molejar/easyboard/README.md

# Rapid Development Platform

EasyBoard Nano (EBN) represent the hardware modular concept for rapid development and prototyping.
Thanks to high scalability it's covering a wide area of applications and technologies.

## EBN HW

## EBN SW
