molejar/easyboard/hw/README.md

# EasyBoard Nano HW

* [EBN_KL27Z4](EBN_KL27Z4) - KL27Z4 Core Shield
* [EBN_FMPA](EBN_FMPA) - FM Radio + 2x5W PA Shield
* [EBN_OLED](EBN_OLED) - I2C and SPI OLED Shield
* [EBN_S12D](EBN_S12D) - 12 Dimension Sensor Shield
* [EBN_WPWR](EBN_WPWR) - Wireless Power Shield
* [EBN_SBAT](EBN_SBAT) - Smart Battery Shield
* [EBN_STOR](EBN_STOR) - Storage Shield
* [EBN_GPS](EBN_GPS) - GPS + SD Card Shield
* [EBN_DUAL](EBN_DUAL) - Extendable Shield
* [EBN_PROTO](EBN_PROTO) - Prototype Shield
