molejar/easyboard/hw/EBN_FMPA/README.md

# EBN: FM Radio Shield

#### General Info

* **Base On:** RDA5807M (Single-Chip Broadcast FM Radio Tuner with RDS)
* **Output PA:** PAM8403/PAM8406 (FilterLess 3W/5W Class-D Stereo Audio Amplifier)
* **Control Pins:** Two GPIOs for Enable/Disable MUTE and SHUTDOWN
* **Main Interface:** I2C for tuning and controlling RDA5807M

### Blocking Diagram

<p align="center">
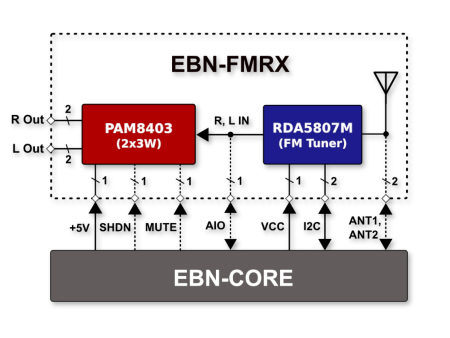
[picture p1: hw/EBN_FMPA/images/EBN_FMRX_V01_BD.png]
EBN-FMPA Block Diagram
  
</p>

### PinOut

<p align="center">
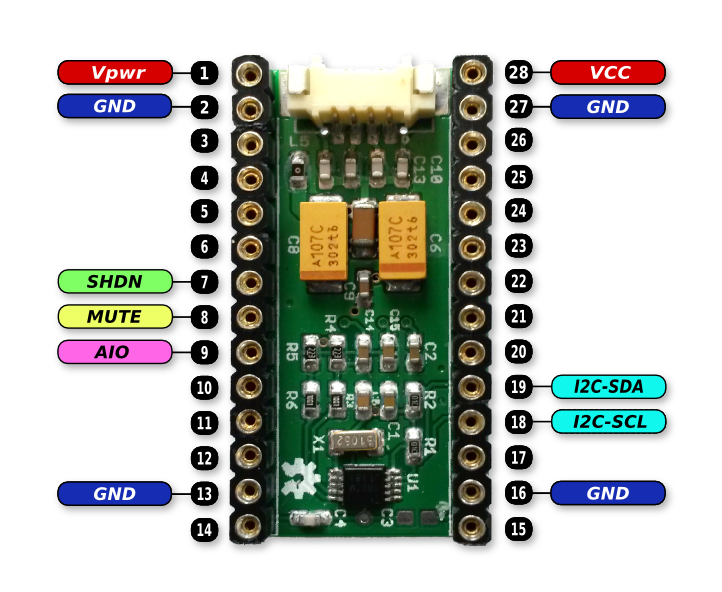
[picture p2: hw/EBN_FMPA/images/EBN_FMRX_V01_PinOut.png]
EBN-FMPA PinOut
  
</p>

#### Connection with Core Shield

| EBN-FMPA | EBN-KL27Z4  |
| --- | --- |
| I2C-SDA | PTB1 |
| I2C-SCL | PTB0 |
| SHDN | PTA1 |
| MUTE | PTA2 |
| AIO | PTE30 |

### Design files

 * [Schematic & PCB (Eagle 7.x)](eagle)
