molejar/easyboard/hw/EBN_KL27Z4/README.md

# EBN: KL27Z4 Core Shield

#### General Info

* **MCU:** Freescale MKL27Z256VFM4 in QFN32 package
* **ARM Core:** Cortex-M0+, 50MHz (max)
* **Memory's:** 256kB Flash and 32kB RAM
* **Serial Interfaces:** 1xUSB-Device, 3xUART, 2xSPI, 2xI2C, 1xI2S, ...
* **Other:** 16-bit ADC, 12-bit DAC, RTC, FlexIO (4xIO-Pins)

### Blocking Diagram

<p align="center">
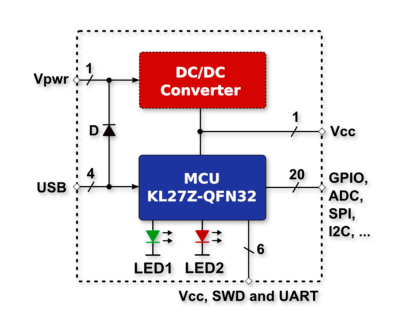
[picture p5: hw/EBN_KL27Z4/images/EBN_CORE_KL27Z4_V04_BD.png]
EBN-KL27Z Block Diagram
  
</p>

### PinOut

<p align="center">
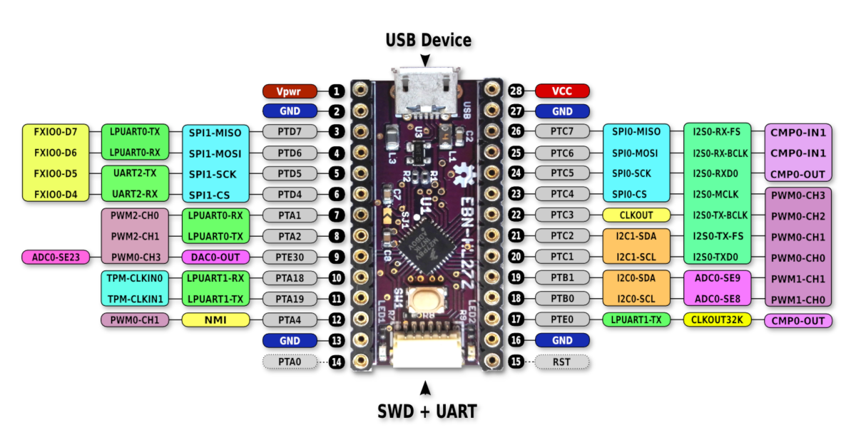
[picture p6: hw/EBN_KL27Z4/images/EBN_CORE_KL27Z4_V05_PinOut.png]
EBN-KL27Z PinOut
  
</p>

#### Internal Connections

| Name | Pin | Description |
| --- | --- | --- |
| LED1 (Green) | VCC | Power Status LED |
| LED2 (Red) | PTA3 | User or Error Status LED |
| SW1 (Button) | PTA4 | Enter into Bootloader |

### Design files

 * [Schematic & PCB (Eagle 7.x)](eagle)

### OSH Park
