molejar/easyboard/hw/EBN_PROTO/README.md

# EBN: Prototype Shield

#### General Info

### Design files

 * [Schematic & PCB (Eagle 7.x)](eagle)
