molejar/easyboard/hw/EBN_S12D/README.md

# EBN: Sensor Shield

#### General Info

* **Accelerometer:** FXOS8700
* **Magnetometer:** FXOS8700
* **Barometer:** MPL3115
* **Gyroscope:** FXAS21002
* **Humidity:** SHT2X

### Block Diagram

<p align="center">
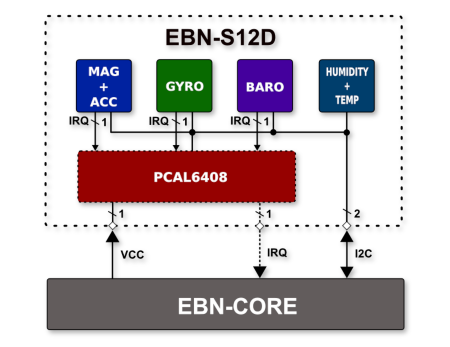
[picture p10: hw/EBN_S12D/images/EBN_S12D_V02_BD.png]
EBN-S12D Block Diagram
  
</p>

### PinOut

<p align="center">
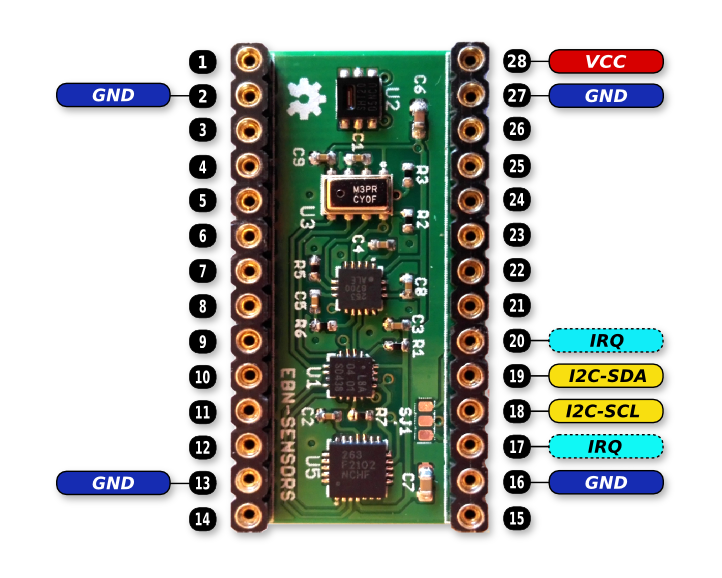
[picture p11: hw/EBN_S12D/images/EBN_S12D_V02_PinOut.png]
EBN-S12D PinOut
  
</p>

#### Connection with Core Shield

| EBN-S12D | EBN-KL27Z4  |
| --- | --- |
| I2C-SDA | PTB1 |
| I2C-SCL | PTB0 |
| IRQ (20 / 17) | PTC1 / PTE0 |

### Design files

 * [Schematic & PCB (Eagle 7.x)](eagle)
