molejar/easyboard/hw/EBN_SBAT/README.md

# EBN: Smart Battery Shield

#### General Info

* **Charger:** TI bq24075 (1A Li-Ion linear charger with power path)
* **BMS:** TI bq27421-G1 (System-Side Impedance Track Fuel Gauge With Integrated Sense Resistor)
* **DC/DC:** TI TPS6300x (High Efficient Single Inductor Buck-Boost Converter 3.3V/1A)

### Blocking Diagram

<p align="center">
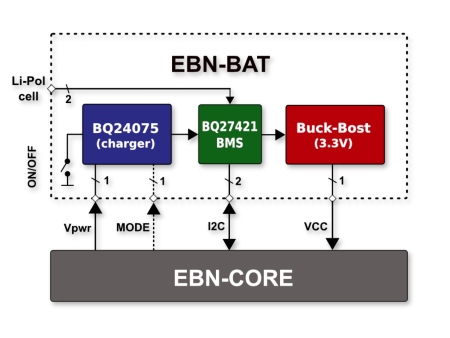
[picture p12: hw/EBN_SBAT/images/EBN_SBAT_V01_BD.png]
EBN-SBAT Block Diagram
  
</p>

### PinOut

<p align="center">
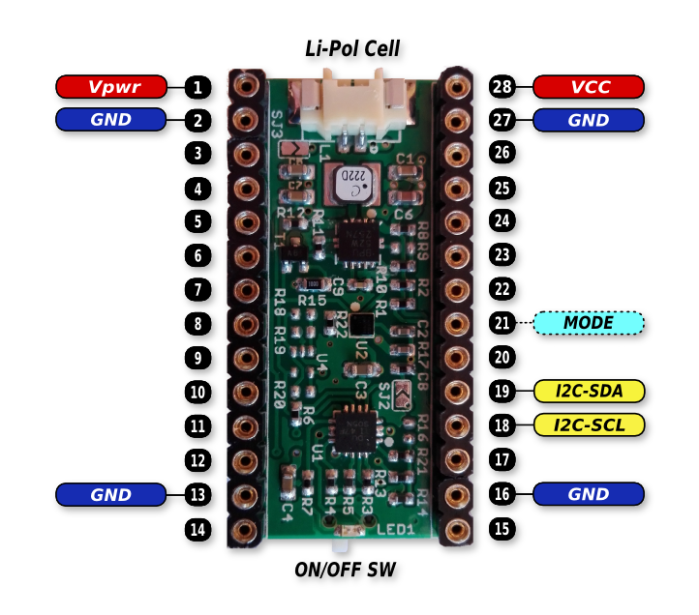
[picture p13: hw/EBN_SBAT/images/EBN_SBAT_V01_PinOut.png]
EBN-SBAT PinOut
  
</p>

#### Connection with Core Shield

| EBN-SBAT | EBN-KL27Z4  |
| --- | --- |
| I2C-SDA | PTB1 |
| I2C-SCL | PTB0 |
| MODE | PTC2 |

### Design files

 * [Schematic & PCB (Eagle 7.x)](eagle)

### OSH Park
