molejar/easyboard/hw/EBN_STOR/README.md

# EBN: Storage Shield

#### General Info

* **Base On:** Three different kinds of memories (SD Card, NAND Flash and EEPROM)
* **Micro SD Card:** Any type compatible with 3.3V power and SPI I/O interface
* **SPI Flash:**  ...
* **I2C EEPROM:**  ...

### Block Diagram of Storage Shield

<p align="center">
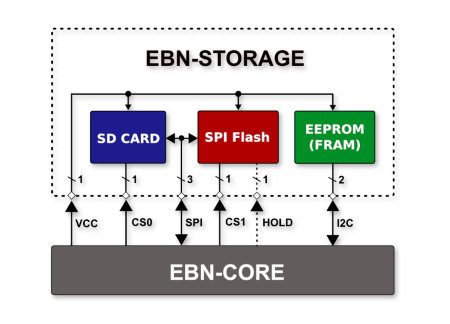
[picture p14: hw/EBN_STOR/images/EBN_STORAGE_V01_BD.png]
EBN-STORAGE Block Diagram
  
</p>

### PinOut

<p align="center">
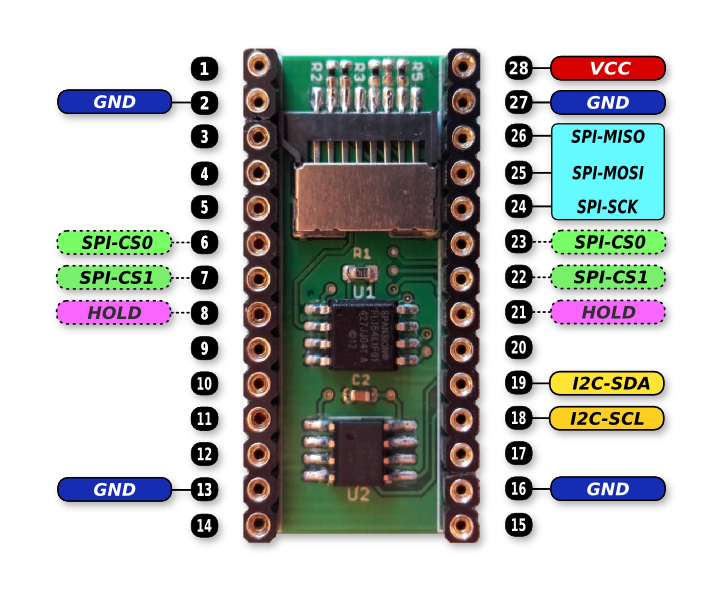
[picture p15: hw/EBN_STOR/images/EBN_STORAGE_V01_PinOut.png]
EBN-STORAGE PinOut
  
</p>

#### Connection with Core Shield

| EBN-STORAGE | EBN-KL27Z4  |
| --- | --- |
| SPI-MISO | PTC7 |
| SPI-MOSI | PTC6 |
| SPI-SCKL | PTC5 |
| SPI-CS0 (06 / 23) | PTD4 / PTC4 |
| SPI-CS1 (07 / 22) | PTA1 / PTC3 |
| HOLD (08 / 21) | PTA2 / PTC2 |
| I2C-SDA | PTB1 |
| I2C-SCL | PTB0 |

### Design files

 * [Schematic & PCB (Eagle 7.x)](eagle)
