molejar/easyboard/hw/EBN_WPWR/README.md

# EBN: Wireless Power Shield

#### General Info

* **Base On:** TI bq51013B (Highly Integrated Wireless Receiver Qi with 5V/1A Output)
* **DC/DC:** Optional DC/DC Buck Converter with 3.3V/1A Output

### Block Diagram

<p align="center">
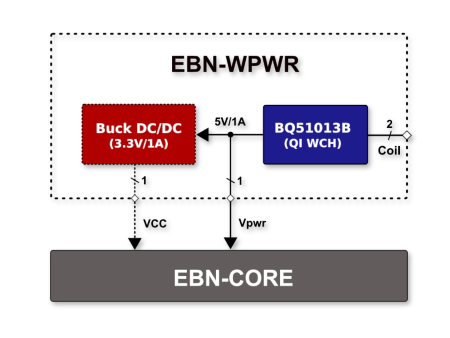
[picture p16: hw/EBN_WPWR/images/EBN_WPWR_V01_BD.png]
EBN-WPWR Block Diagram
  
</p>

### PinOut

<p align="center">
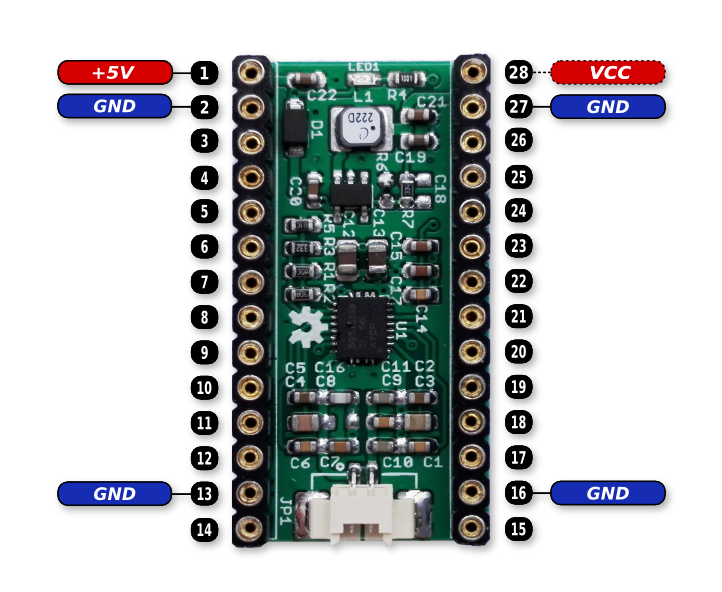
[picture p17: hw/EBN_WPWR/images/EBN_WPWR_V01_PinOut.png]
EBN-STORAGE PinOut
  
</p>

### Design files

 * [Schematic & PCB (Eagle 7.x)](eagle)
