molejar/easyboard/hw/EBN_FMPA/images/EBN_FMRX_V01_Bottom.png

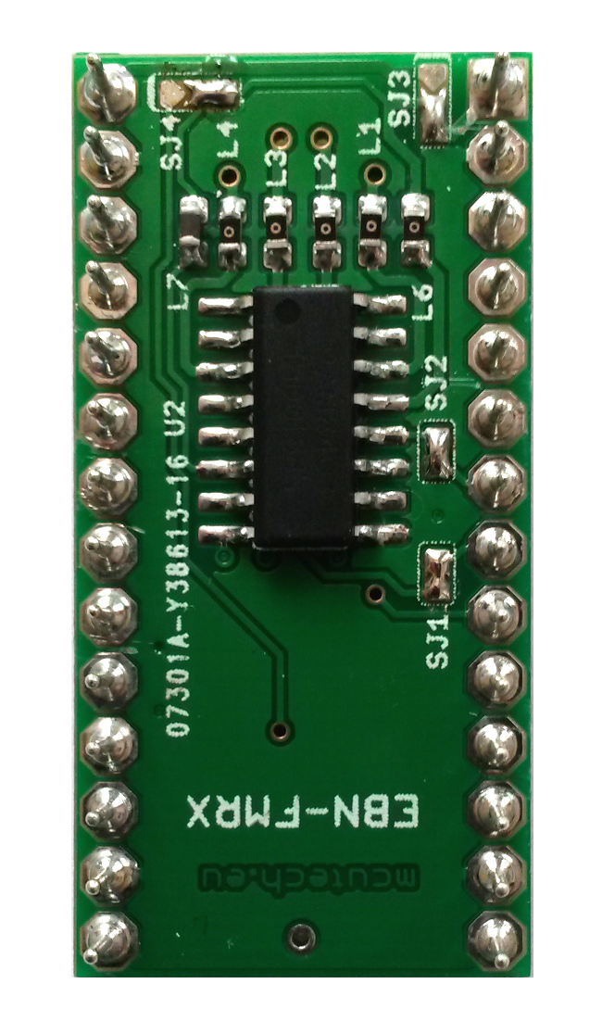
hw/EBN_FMPA/images/EBN_FMRX_V01_Bottom.png
