molejar/easyboard/hw/EBN_FMPA/images/EBN_FMRX_V01_Top.png

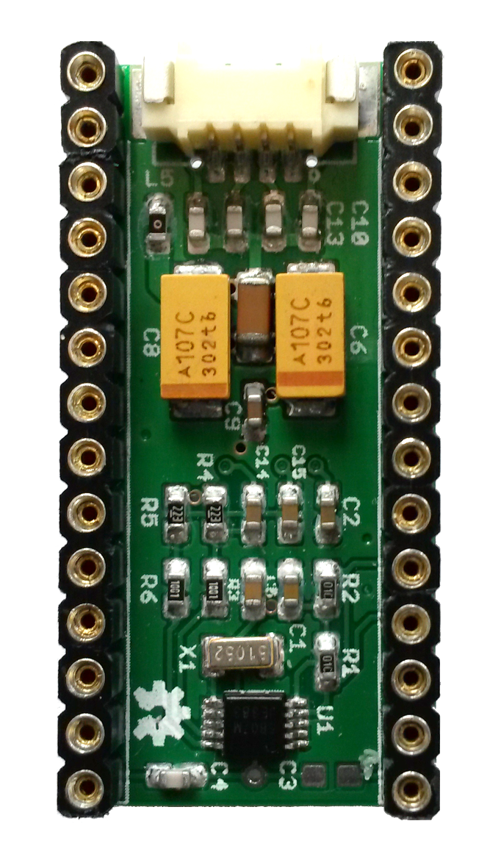
hw/EBN_FMPA/images/EBN_FMRX_V01_Top.png
