molejar/easyboard/hw/EBN_GPS/images/EBN_GPS_V02_Bottom.png

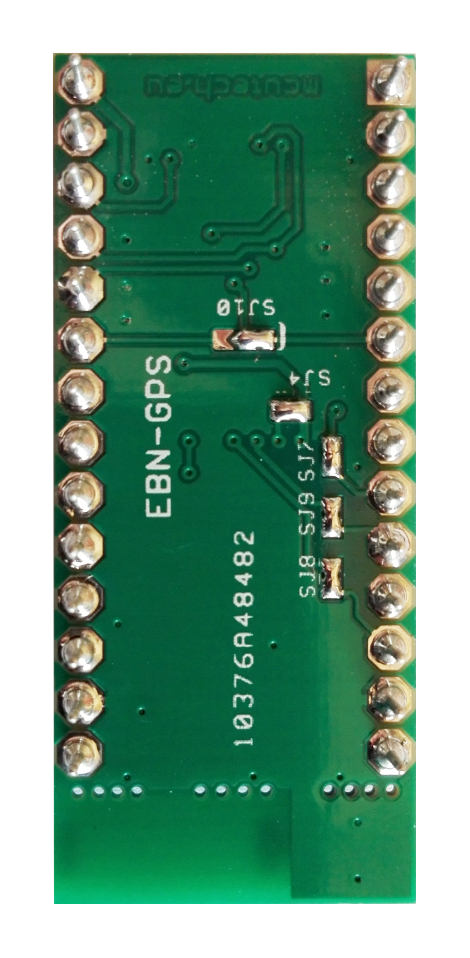
hw/EBN_GPS/images/EBN_GPS_V02_Bottom.png
