molejar/easyboard/hw/EBN_GPS/images/EBN_GPS_V02_Top.png

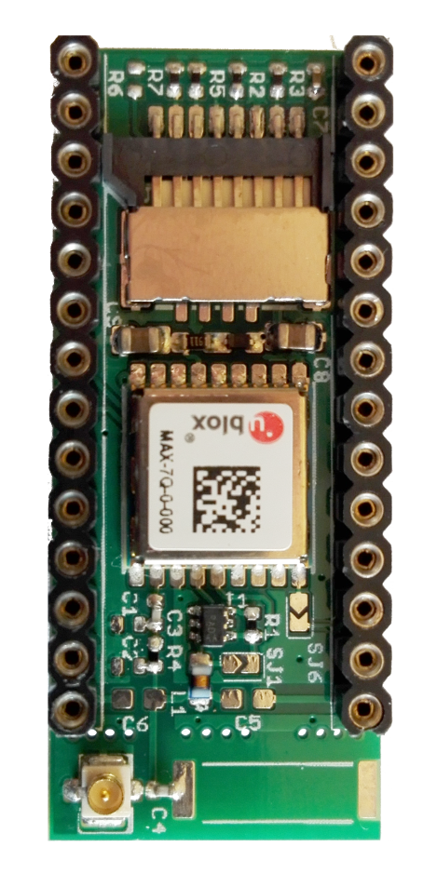
hw/EBN_GPS/images/EBN_GPS_V02_Top.png
