molejar/easyboard/hw/EBN_GPS/images/EBN_GPS_V02_WithAntenna.png

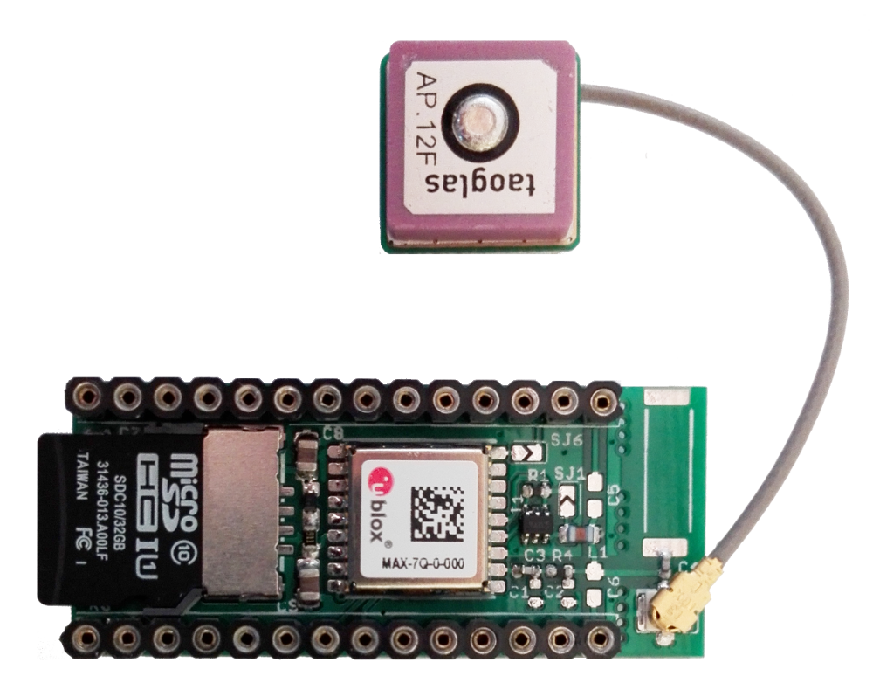
hw/EBN_GPS/images/EBN_GPS_V02_WithAntenna.png
