molejar/easyboard/hw/EBN_KL27Z4/images/EBN_CORE_KL27Z4_V04_Top.png

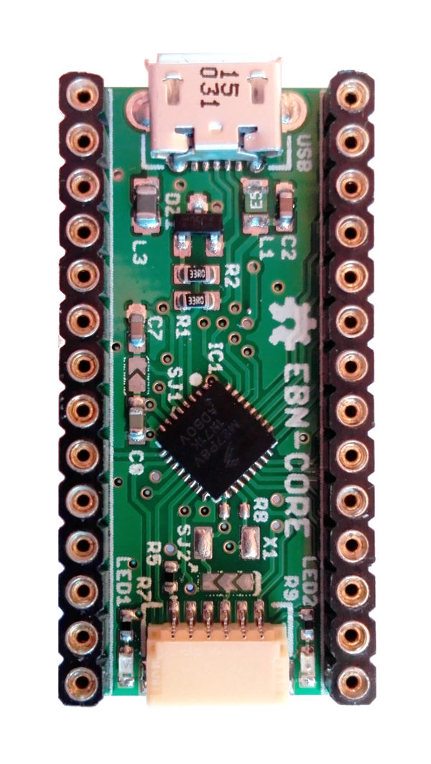
hw/EBN_KL27Z4/images/EBN_CORE_KL27Z4_V04_Top.png
