molejar/easyboard/hw/EBN_OLED/images/EBN_OLED_V01_BD_I2C.png

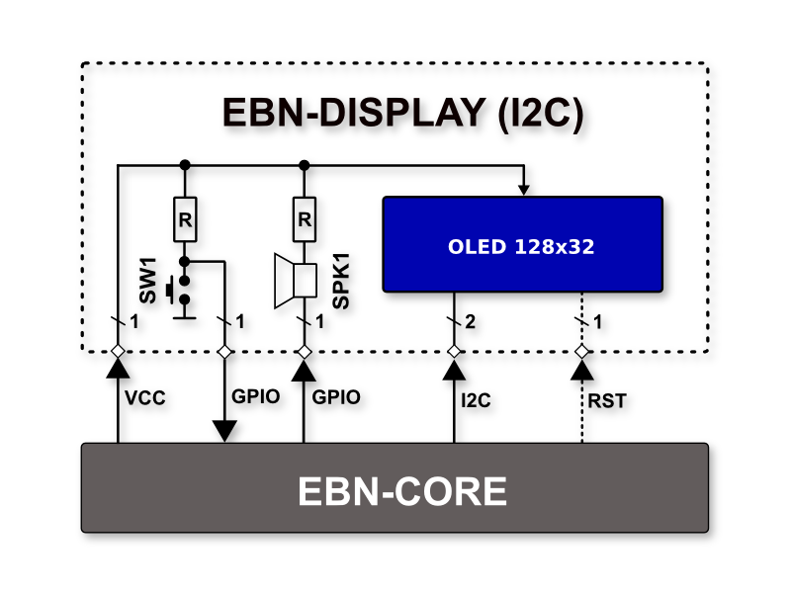
hw/EBN_OLED/images/EBN_OLED_V01_BD_I2C.png
