molejar/easyboard/hw/EBN_OLED/images/EBN_OLED_V01_Top.png

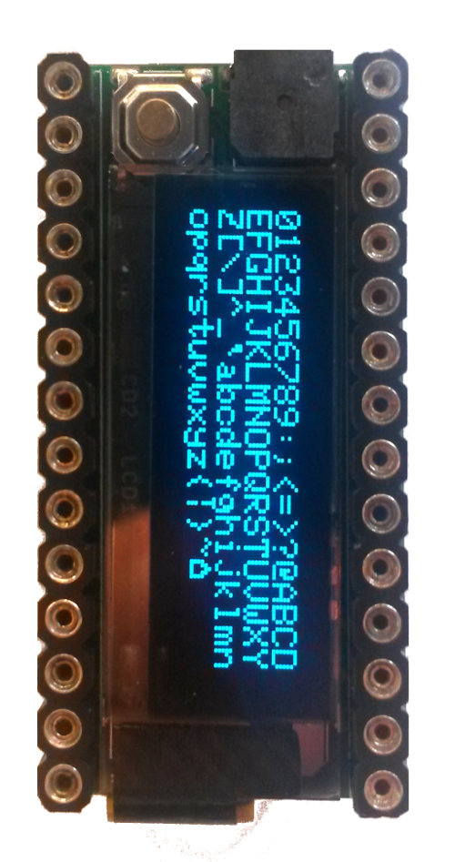
hw/EBN_OLED/images/EBN_OLED_V01_Top.png
