molejar/easyboard/hw/EBN_PROTO/images/EBN_Proto_V01_Top.png

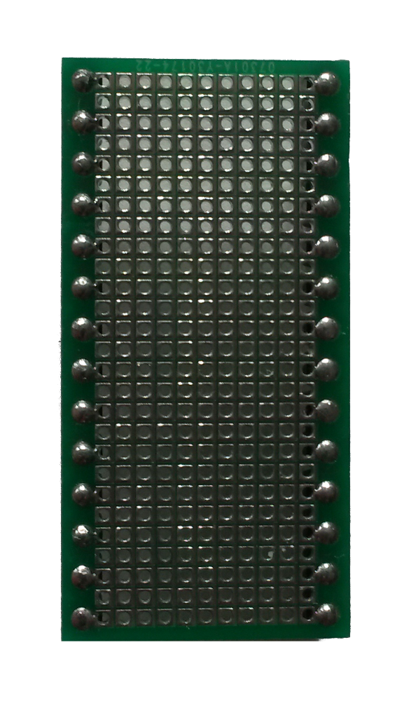
hw/EBN_PROTO/images/EBN_Proto_V01_Top.png
