molejar/easyboard/hw/EBN_S12D/images/EBN_S12D_V02_Top.png

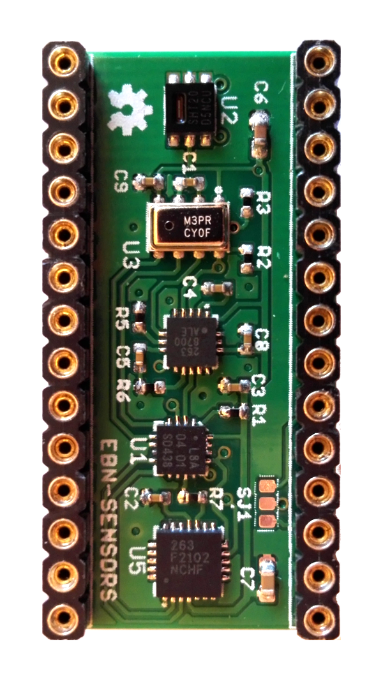
hw/EBN_S12D/images/EBN_S12D_V02_Top.png
