molejar/easyboard/hw/EBN_SBAT/images/EBN_SBAT_V01_Top.png

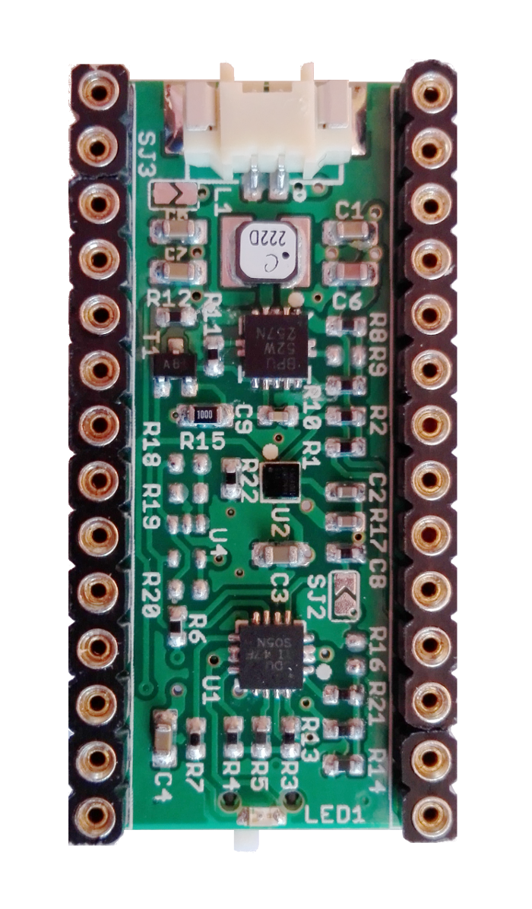
hw/EBN_SBAT/images/EBN_SBAT_V01_Top.png
