molejar/easyboard/hw/EBN_STOR/images/EBN_STORAGE_V01_Top.png

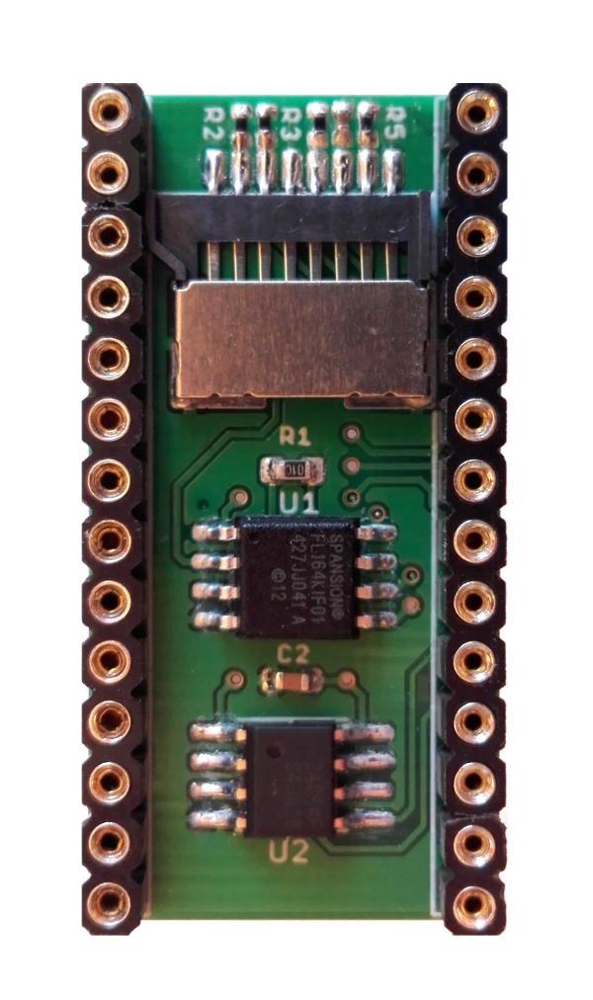
hw/EBN_STOR/images/EBN_STORAGE_V01_Top.png
