molejar/easyboard/hw/EBN_WPWR/images/EBN_WPWR_V01_Bottom.png

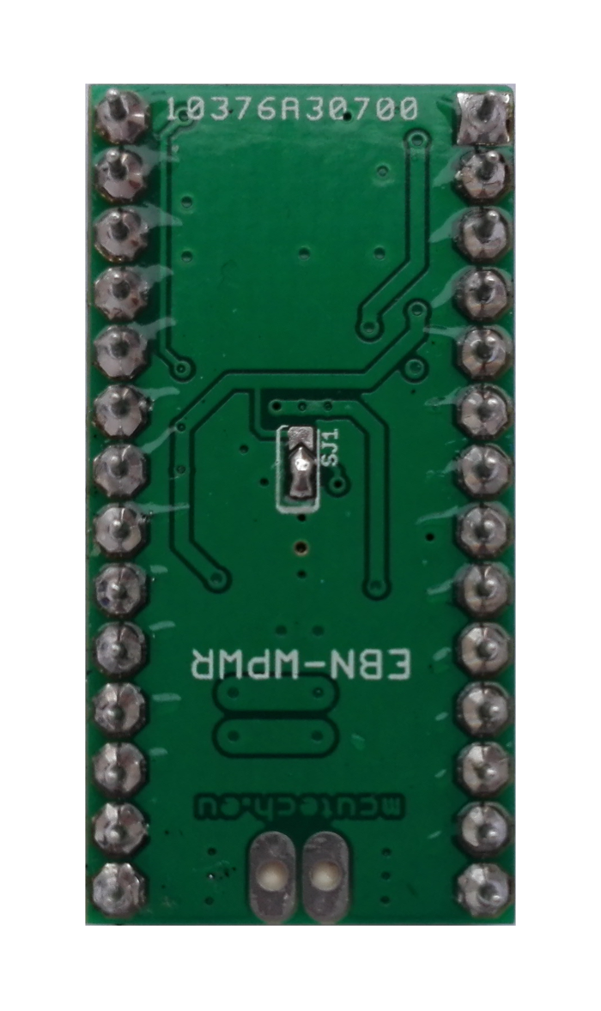
hw/EBN_WPWR/images/EBN_WPWR_V01_Bottom.png
