molejar/easyboard/hw/EBN_WPWR/images/EBN_WPWR_V01_Top.png

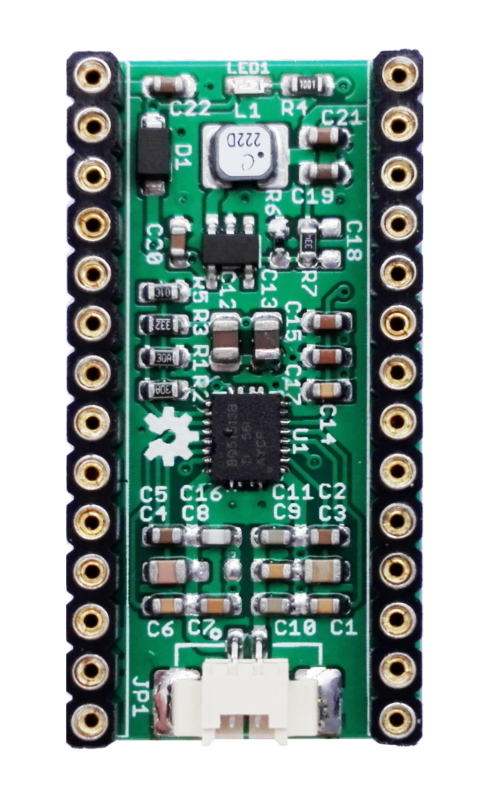
hw/EBN_WPWR/images/EBN_WPWR_V01_Top.png
