molejar/easyboard/hw/EBN_FMPA/eagle/EBN_FMRX_V02.brd

## EAGLE design hw/EBN_FMPA/eagle/EBN_FMRX_V02.brd (2019-03-24)

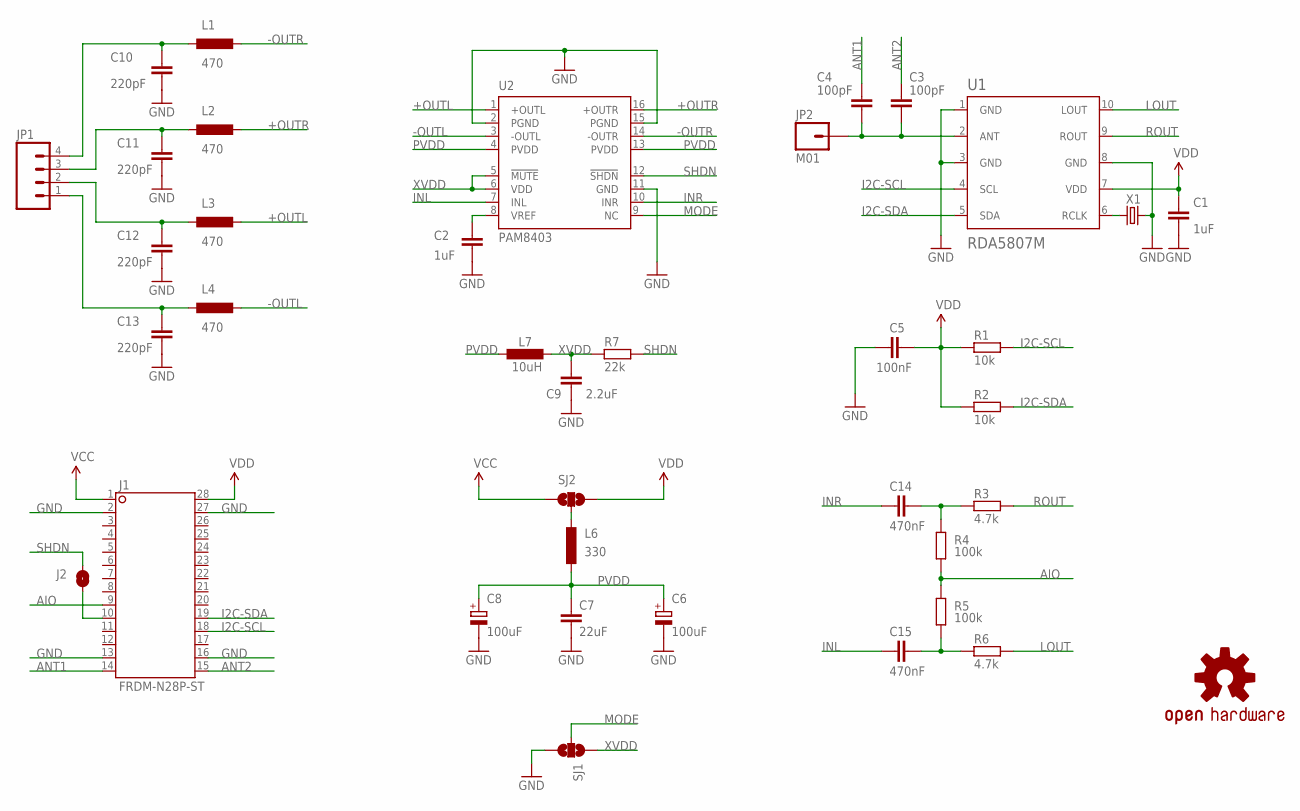
[picture p39: schematic EBN_FMRX_V02.sch]

Parts:
C1, C2: 1uF; C0603
C3, C4: 100pF; C0603
C5: 100nF; C0603
C6, C8: 100uF; SMC_C
C7: 22uF; C1206
C9: 2.2uF; C0603
C10, C11, C12, C13: 220pF; C0603
C14, C15: 470nF; C0603
J1: FRDM-N28P-ST; FRDM-N28P-SHIELD
J2: SJ-S; JUMPER-SMD-S1X
JP1: M04SMD_1.25MM; 1X04-1.25MM_SMD
JP2: M01; 1X01-EXTRA
L1, L2, L3, L4: 470; L0805
L6: 330; L0805
L7: 10uH; L0805
LOGO1: OSHW-LOGOS; OSHW-LOGO-S
R1, R2: 10k; R0603
R3, R6: 4.7k; R0603
R4, R5: 100k; R0603
R7: 22k; R0603
SJ1, SJ2: SJ2W-S; JUMPER-SMD-S2X
U1: RDA5807M; MSOP10
U2: PAM8403; SO16
X1: XTAL1-SMD-2P-3.2X1.5MM; SMD-2X-3215

Connections:
+OUTL: L3.2, U2.1 (+OUTL)
+OUTR: L2.2, U2.16 (+OUTR)
-OUTL: L4.2, U2.3 (-OUTL)
-OUTR: L1.2, U2.14 (-OUTR)
AIO: J1.9, R4.2, R5.2
ANT1: C4.1, J1.14
ANT2: C3.1, J1.15
GND: C1.1, C2.2, C5.2, C6.-, C7.1, C8.-, C9.1, C10.1, C11.1, C12.1, C13.1, J1.2, J1.13, J1.16, J1.27, SJ1.3, U1.1 (GND), U1.3 (GND), U1.8 (GND), U2.2 (PGND), U2.11 (GND), U2.15 (PGND), X1.2
I2C-SCL: J1.18, R1.2, U1.4 (SCL)
I2C-SDA: J1.19, R2.2, U1.5 (SDA)
INL: C15.2, U2.7 (INL)
INR: C14.2, U2.10 (INR)
LOUT: R6.2, U1.10 (LOUT)
MODE: SJ1.2, U2.9 (NC)
unnamed: C2.1, U2.8 (VREF)
unnamed: C10.2, JP1.4, L1.1
unnamed: C3.2, C4.2, JP2.P$1, U1.2 (ANT)
unnamed: C11.2, JP1.3, L2.1
unnamed: C12.2, JP1.2, L3.1
unnamed: U1.6 (RCLK), X1.1
unnamed: J1.10, J2.1
unnamed: C13.2, JP1.1, L4.1
unnamed: L6.2, SJ2.2
unnamed: C14.1, R3.1, R4.1
unnamed: C15.1, R5.1, R6.1
PVDD: C6.+, C7.2, C8.+, L6.1, L7.1, U2.4 (PVDD), U2.13 (PVDD)
ROUT: R3.2, U1.9 (ROUT)
SHDN: J2.2, R7.2, U2.12 (!SHDN)
VCC: J1.1, SJ2.1
VDD: C1.2, C5.1, J1.28, R1.1, R2.1, SJ2.3, U1.7 (VDD)
XVDD: C9.2, L7.2, R7.1, SJ1.1, U2.5 (!MUTE), U2.6 (VDD)

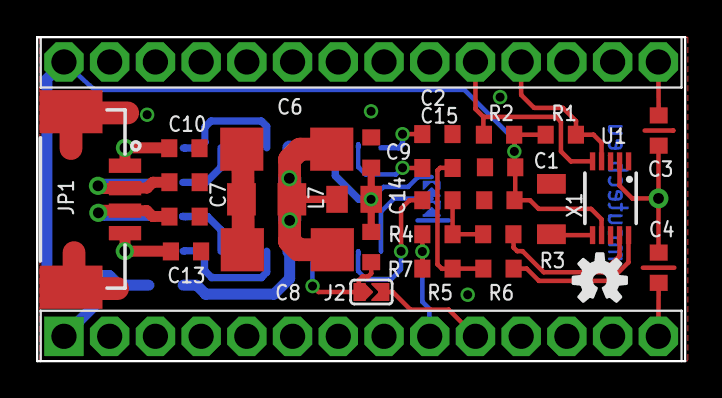
[picture p40: board EBN_FMRX_V02.brd from above]

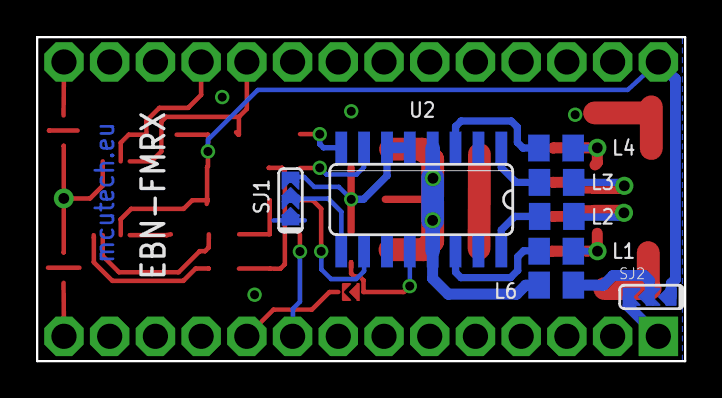
[picture p41: board EBN_FMRX_V02.brd from below]

Board: 2 copper layers, 36.0 x 18.0 mm, 38 parts (8 on the bottom side), 31 nets.
