molejar/easyboard/hw/EBN_WPWR/eagle/EBN_WPWR_V01.brd

## EAGLE design hw/EBN_WPWR/eagle/EBN_WPWR_V01.brd (2019-03-24)

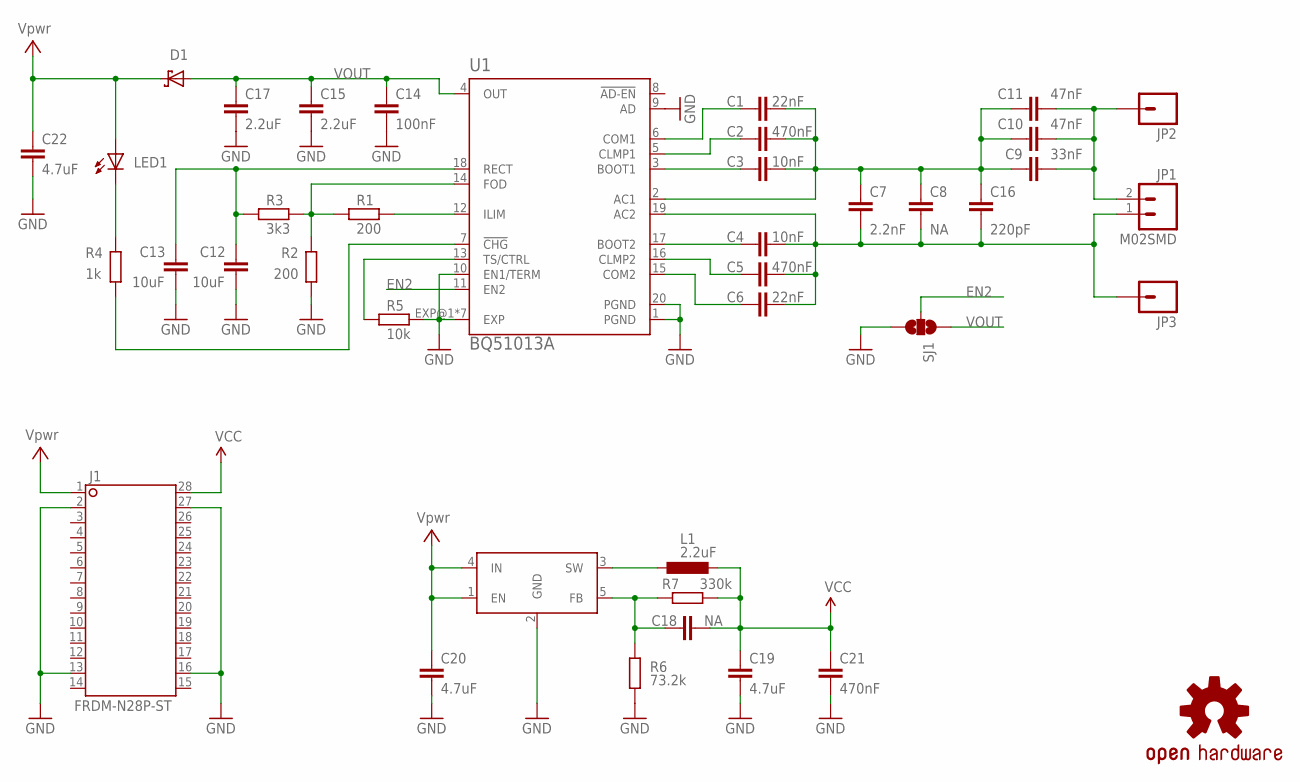
[picture p42: schematic EBN_WPWR_V01.sch]

Parts:
C1, C6: 22nF; C0603
C2, C5, C21: 470nF; C0603
C3, C4: 10nF; C0603
C7: 2.2nF; C0603
C8, C18: NA; C0603
C9: 33nF; C0603
C10, C11: 47nF; C0603
C12, C13: 10uF; C0805
C14: 100nF; C0603
C15, C17: 2.2uF; C0603
C16: 220pF; C0603
C19, C20, C22: 4.7uF; C0603
D1: PMEG2010BER-SHOTTKY-SOD123FL; SOD-123FL
J1: FRDM-N28P-ST; FRDM-N28P-SHIELD
JP1: M02SMD; 1X02-1.25MM_SMD
JP2, JP3: M01PTH_LONGPAD; 1X01_LONGPAD
L1: 2.2uF; LPS3015
LED1: LEDCHIPLED_0603; CHIPLED_0603
LOGO1: OSHW-LOGOS; OSHW-LOGO-S
R1, R2: 200; R0603
R3: 3k3; R0603
R4: 1k; R0603
R5: 10k; R0603
R6: 73.2k; R0603
R7: 330k; R0603
SJ1: SJ2W-S; JUMPER-SMD-S2X
U1: BQ51013A; RHL_R-VQFN-N20
U$1: MP215P; SOT23-5L

Connections:
EN2: SJ1.2, U1.11 (EN2)
GND: C12.1, C13.1, C14.1, C15.1, C17.1, C19.1, C20.1, C21.1, C22.1, J1.2, J1.13, J1.16, J1.27, R2.1, R5.2, R6.1, SJ1.3, U1.1 (PGND), U1.9 (AD), U1.10 (EN1/TERM), U1.20 (PGND), U1.EXP@1 (EXP), U1.EXP@2 (EXP), U1.EXP@3 (EXP), U1.EXP@4 (EXP), U1.EXP@5 (EXP), U1.EXP@6 (EXP), U1.EXP@7 (EXP), U$1.2 (GND)
unnamed: C3.1, U1.3 (BOOT1)
unnamed: C2.1, U1.5 (CLMP1)
unnamed: C1.1, U1.6 (COM1)
unnamed: C1.2, C2.2, C3.2, C7.2, C8.2, C9.2, C10.2, C11.2, C16.2, U1.2 (AC1)
unnamed: C4.2, C5.2, C6.2, C7.1, C8.1, C16.1, JP1.1, JP3.1, U1.19 (AC2)
unnamed: C4.1, U1.17 (BOOT2)
unnamed: C5.1, U1.16 (CLMP2)
unnamed: C6.1, U1.15 (COM2)
unnamed: C9.1, C10.1, C11.1, JP1.2, JP2.1
unnamed: LED1.C, R4.2
unnamed: R4.1, U1.7 (!CHG)
unnamed: R1.2, U1.12 (ILIM)
unnamed: R1.1, R2.2, R3.1, U1.14 (FOD)
unnamed: C12.2, C13.2, R3.2, U1.18 (RECT)
unnamed: L1.P$1 (1), U$1.3 (SW)
unnamed: C18.2, R6.2, R7.2, U$1.5 (FB)
PWR: C20.2, C22.2, D1.C, J1.1, LED1.A, U$1.1 (EN), U$1.4 (IN)
TS: R5.1, U1.13 (TS/CTRL)
VCC: C18.1, C19.2, C21.2, J1.28, L1.P$2 (2), R7.1
VOUT: C14.2, C15.2, C17.2, D1.A, SJ1.1, U1.4 (OUT)

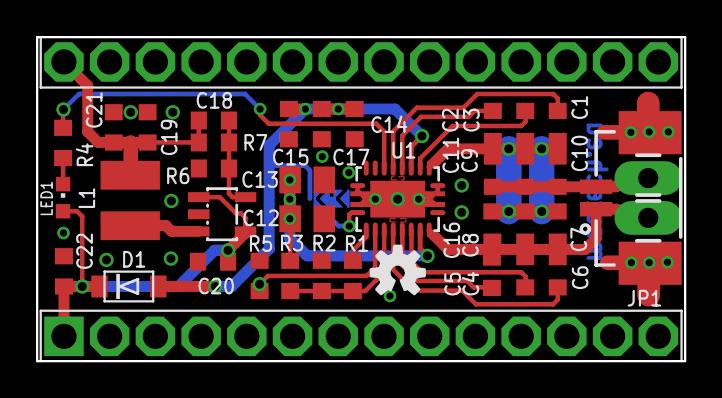
[picture p43: board EBN_WPWR_V01.brd from above]

Board: 2 copper layers, 36.0 x 18.0 mm, 40 parts (1 on the bottom side), 22 nets.
