molejar/easyboard/hw/EBN_STOR/eagle/EBN_Storage_V01.brd

## EAGLE design hw/EBN_STOR/eagle/EBN_Storage_V01.brd (2019-03-24)

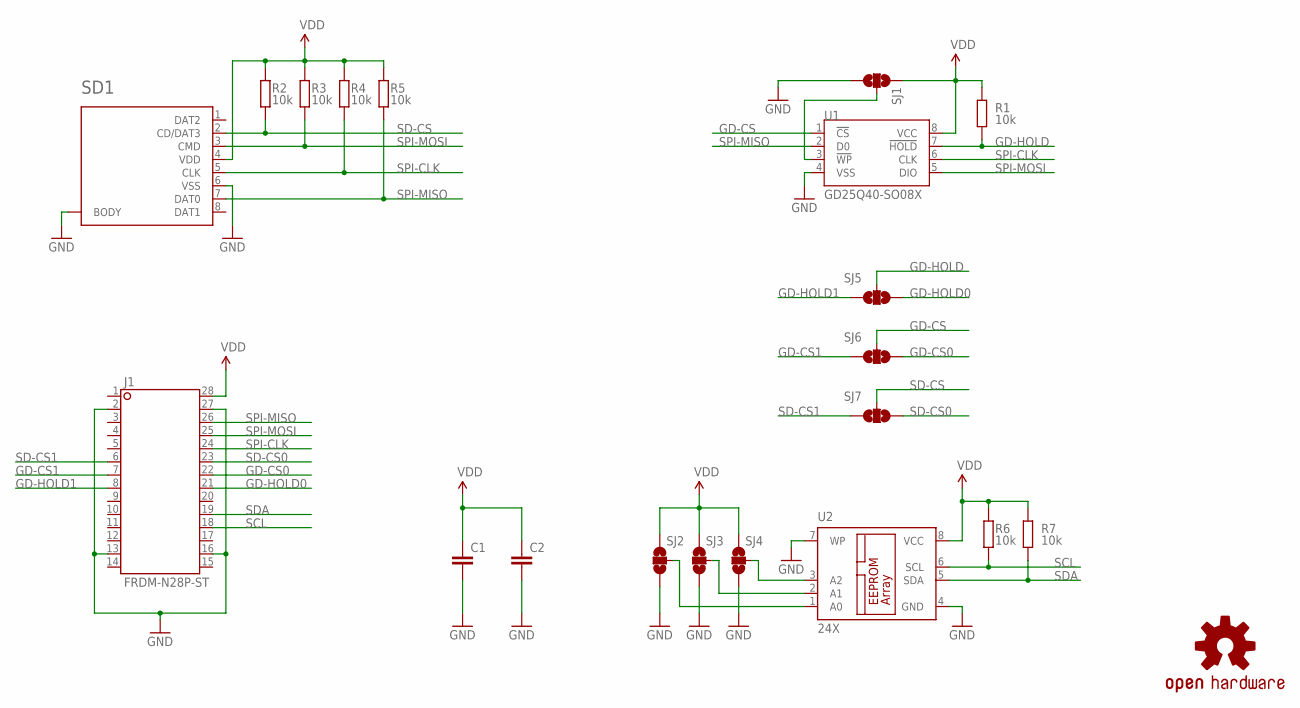
[picture p44: schematic EBN_Storage_V01.sch]

Parts:
C1: C-EUC0402; C0402
C2: C-EUC0603; C0603
J1: FRDM-N28P-ST; FRDM-N28P-SHIELD
LOGO1: OSHW-LOGOM; OSHW-LOGO-M
R1, R6, R7: 10k; R0603
R2, R3, R4, R5: 10k; R0402
SD1: SDCARD; MICRO-SD-01
SJ1, SJ2, SJ3, SJ4, SJ5, SJ6, SJ7: SJ2W-S; JUMPER-SMD-S2X
U1: GD25Q40-SO08X; SO08X@1
U2: 24X; SO08X

Connections:
GD-CS: SJ6.2, U1.1 (!CS)
GD-CS0: J1.22, SJ6.1
GD-CS1: J1.7, SJ6.3
GD-HOLD: R1.1, SJ5.2, U1.7 (!HOLD)
GD-HOLD0: J1.21, SJ5.1
GD-HOLD1: J1.8, SJ5.3
GND: C1.2, C2.2, J1.2, J1.13, J1.16, J1.27, SD1.6 (VSS), SD1.SHELD@0 (BODY), SD1.SHELD@1 (BODY), SJ1.1, SJ2.1, SJ3.1, SJ4.1, U1.4 (VSS), U2.4 (GND), U2.7 (WP)
unnamed: SJ4.2, U2.3 (A2)
unnamed: SJ1.2, U1.3 (!WP)
unnamed: SJ3.2, U2.2 (A1)
unnamed: SJ2.2, U2.1 (A0)
SCL: J1.18, R6.1, U2.6 (SCL)
SD-CS: R2.1, SD1.2 (CD/DAT3), SJ7.2
SD-CS0: J1.23, SJ7.1
SD-CS1: J1.6, SJ7.3
SDA: J1.19, R7.1, U2.5 (SDA)
SPI-CLK: J1.24, R4.1, SD1.5 (CLK), U1.6 (CLK)
SPI-MISO: J1.26, R5.1, SD1.7 (DAT0), U1.2 (D0)
SPI-MOSI: J1.25, R3.1, SD1.3 (CMD), U1.5 (DIO)
VDD: C1.1, C2.1, J1.28, R1.2, R2.2, R3.2, R4.2, R5.2, R6.2, R7.2, SD1.4 (VDD), SJ1.3, SJ2.3, SJ3.3, SJ4.3, U1.8 (VCC), U2.8 (VCC)

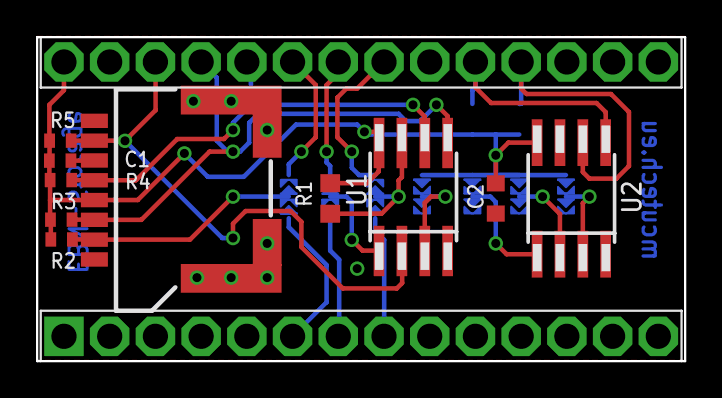
[picture p45: board EBN_Storage_V01.brd from above]

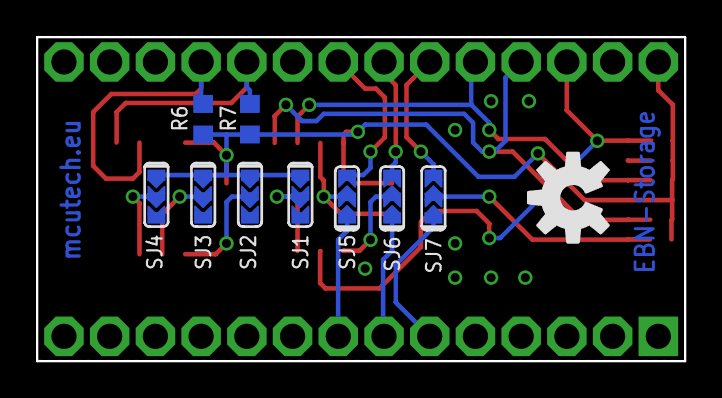
[picture p46: board EBN_Storage_V01.brd from below]

Board: 2 copper layers, 36.0 x 18.0 mm, 21 parts (10 on the bottom side), 20 nets.
