molejar/easyboard/hw/EBN_SBAT/eagle/EBN_SBAT_V03A.brd

## EAGLE design hw/EBN_SBAT/eagle/EBN_SBAT_V03A.brd (2019-03-24)

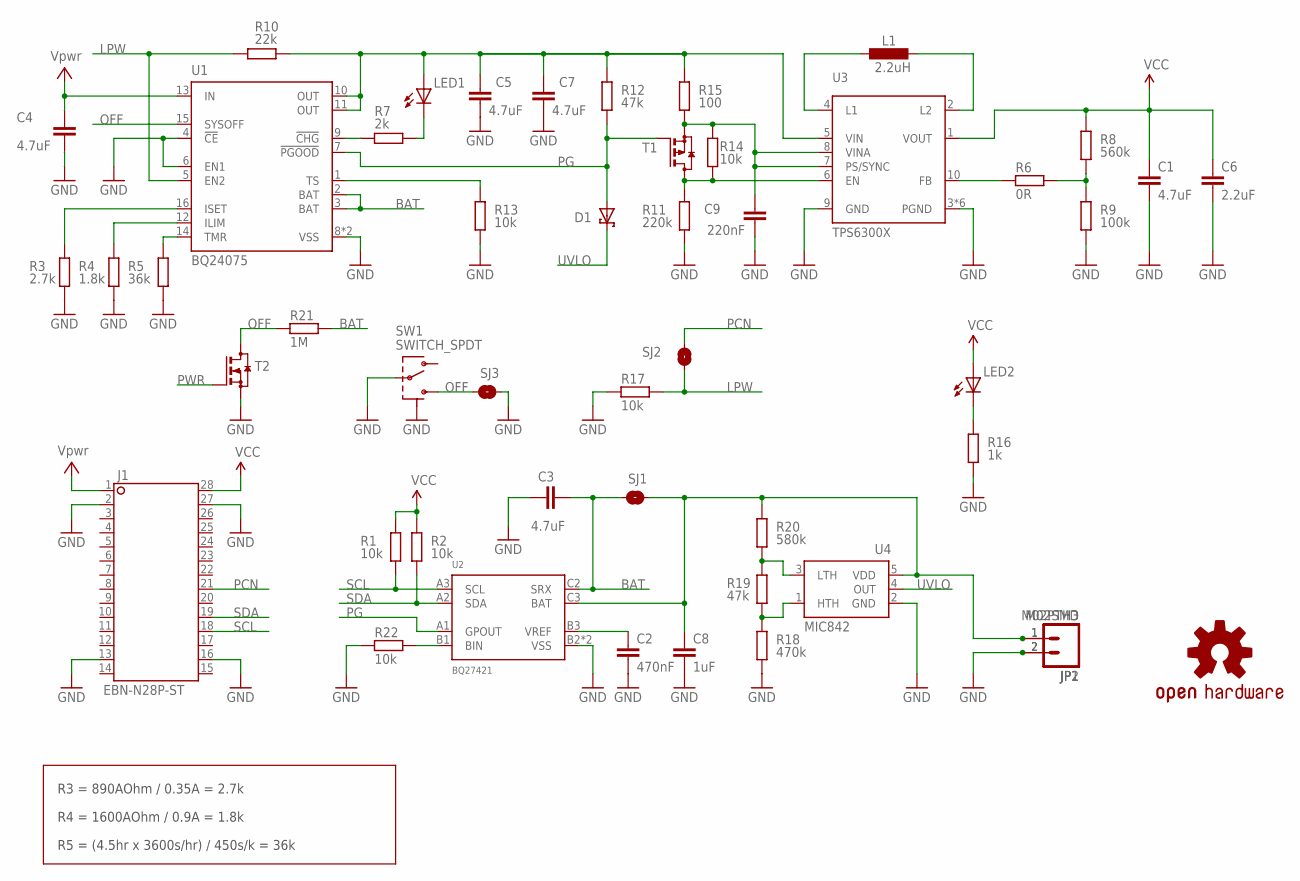
[picture p47: schematic EBN_SBAT_V03A.sch]

Parts:
C1, C4, C5, C7: 4.7uF; C0603
C2: 470nF; C0402
C3: 4.7uF; C0805
C6: 2.2uF; C0603
C8: 1uF; C0402
C9: 220nF; C0402
D1: -SHOTTKY-SOD323_ST; SOD323_ST
J1: EBN-N28P-ST; EBN-N28P-SHIELD
JP1: M02SMD; 1X02-1.25MM_SMD
JP2: M02PTH3; 1X02_LONGPADS
L1: 2.2uH; LPS3015
LED1, LED2: LEDCHIPLED_0603; CHIPLED_0603
LOGO1: OSHW-LOGOS; OSHW-LOGO-S
R1, R2, R13, R14, R17, R22: 10k; R0402
R3: 2.7k; R0402
R4: 1.8k; R0402
R5: 36k; R0402
R6: 0R; R0402
R7: 2k; R0402
R8: 560k; R0402
R9: 100k; R0402
R10: 22k; R0402
R11: 220k; R0402
R12, R19: 47k; R0402
R15: 100; R0402
R16: 1k; R0402
R18: 470k; R0402
R20: 580k; R0402
R21: 1M; R0402
SJ1, SJ2, SJ3: SJ-S; JUMPER-SMD-S1X
SW1: SWITCH_SPDT; SWITCH-SPST-SMD-A
T1: -PMOS-SOT323; SOT323
T2: -NMOS-SOT323; SOT323
U1: BQ24075; QFN16-3X3MM
U2: BQ27421; XBGA9
U3: TPS6300X; QFN-10_PAD
U4: MIC842; SC70

Connections:
BAT: C3.1, R21.1, SJ1.2, U1.2 (BAT), U1.3 (BAT), U2.C2 (SRX)
BATX: C8.2, JP1.1, JP2.1, R20.1, SJ1.1, U2.C3 (BAT), U4.5 (VDD)
GND: C1.2, C2.1, C3.2, C4.2, C5.2, C6.2, C7.2, C8.1, C9.2, J1.2, J1.13, J1.16, J1.27, JP1.2, JP2.2, R3.1, R4.1, R5.1, R9.1, R11.1, R13.1, R16.1, R17.2, R18.1, R22.2, SJ3.2, SW1.2, SW1.GND1 (SH), SW1.GND2 (SH), SW1.GND3 (SH), SW1.GND4 (SH), T2.2 (S), U1.4 (!CE), U1.6 (EN1), U1.8 (VSS), U1.EXT (VSS), U2.B2 (VSS), U2.C1 (VSS), U3.3 (PGND), U3.9 (GND), U3.11 (PGND), U3.12 (PGND), U3.13 (PGND), U3.14 (PGND), U3.15 (PGND), U4.2 (GND)
LPW: R10.2, R17.1, SJ2.1, U1.5 (EN2)
unnamed: L1.P$1 (1), U3.4 (L1)
unnamed: L1.P$2 (2), U3.2 (L2)
unnamed: LED2.C, R16.2
unnamed: C2.2, U2.B3 (VREF)
unnamed: R5.2, U1.14 (TMR)
unnamed: R4.2, U1.12 (ILIM)
unnamed: R18.2, R19.1, U4.1 (HTH)
unnamed: R19.2, R20.2, U4.3 (LTH)
unnamed: C9.1, R14.2, R15.1, T1.2 (S), U3.7 (PS/SYNC), U3.8 (VINA)
unnamed: R22.1, U2.B1 (BIN)
unnamed: R3.2, U1.16 (ISET)
unnamed: C5.1, C7.1, LED1.A, R10.1, R12.2, R15.2, U1.10 (OUT), U1.11 (OUT), U3.5 (VIN)
unnamed: LED1.C, R7.1
unnamed: R7.2, U1.9 (!CHG)
unnamed: R11.2, R14.1, T1.3 (D), U3.6 (EN)
unnamed: R6.1, R8.1, R9.2
unnamed: R6.2, U3.10 (FB)
OFF: R21.2, SJ3.1, SW1.3 (S), T2.3 (D), U1.15 (SYSOFF)
PCN: J1.21, SJ2.2
PG: D1.A, R12.1, T1.1 (G), U1.7 (!PGOOD), U2.A1 (GPOUT)
PWR: C4.1, J1.1, T2.1 (G), U1.13 (IN)
SCL: J1.18, R1.1, U2.A3 (SCL)
SDA: J1.19, R2.1, U2.A2 (SDA)
TS: R13.2, U1.1 (TS)
UVLO: D1.C, U4.4 (OUT)
VCC: C1.1, C6.1, J1.28, LED2.A, R1.2, R2.2, R8.2, U3.1 (VOUT)

Notes on the sheet:
R3 = 890AOhm / 0.35A = 2.7k
R4 = 1600AOhm / 0.9A = 1.8k
R5 = (4.5hr x 3600s/hr) / 450s/k = 36k

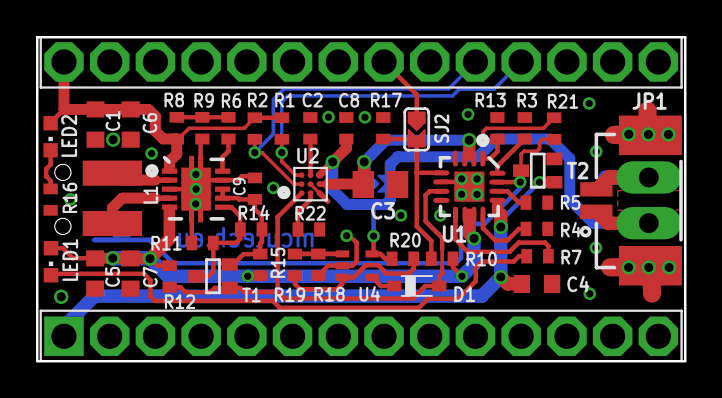
[picture p48: board EBN_SBAT_V03A.brd from above]

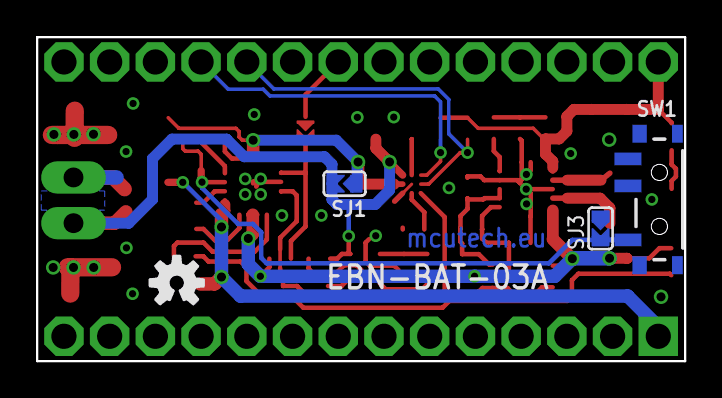
[picture p49: board EBN_SBAT_V03A.brd from below]

Board: 2 copper layers, 36.0 x 18.0 mm, 49 parts (4 on the bottom side), 30 nets.
