molejar/easyboard/hw/EBN_OLED/eagle/EBN_OLED_V01.brd

## EAGLE design hw/EBN_OLED/eagle/EBN_OLED_V01.brd (2019-03-24)

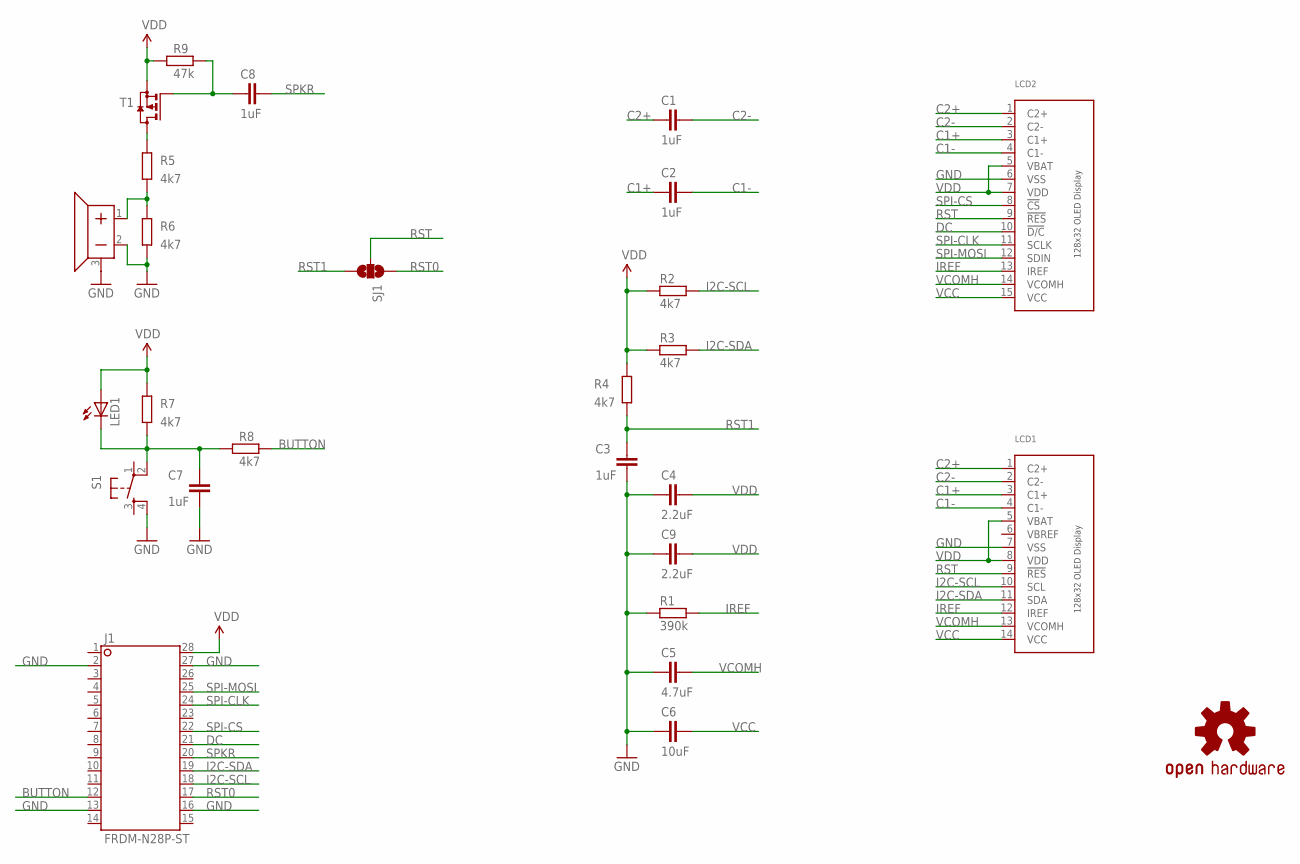
[picture p50: schematic EBN_OLED_V01.sch]

Parts:
C1, C2, C3, C7, C8: 1uF; C0603
C4, C9: 2.2uF; C0603
C5: 4.7uF; C0603
C6: 10uF; C0603
J1: FRDM-N28P-ST; FRDM-N28P-SHIELD
LCD1: DISP_OLED_UG-2832HSWEG02; UG-2832HSWEG02_WRAPUNDER
LCD2: DISP_OLED_UG-2832HSWEG04WRAPAROUND; UG-2832HSWEG04_WRAPAROUND
LED1: LEDCHIPLED_0805; CHIPLED_0805
LOGO1: OSHW-LOGOS; OSHW-LOGO-S
R1: 390k; R0603
R2, R3, R4, R5, R6, R7, R8: 4k7; R0603
R9: 47k; R0603
S1: SWITCH-TACT2; EVQ-PLX
SJ1: SJ2W-S; JUMPER-SMD-S2X
T1: -PMOS-SOT23; SOT23
U$1: SPEAKER; BUZZER-5MM

Connections:
BUTTON: J1.12, R8.1
C1+: C2.1, LCD1.3 (C1+), LCD2.3 (C1+)
C1-: C2.2, LCD1.4 (C1-), LCD2.4 (C1-)
C2+: C1.1, LCD1.1 (C2+), LCD2.1 (C2+)
C2-: C1.2, LCD1.2 (C2-), LCD2.2 (C2-)
DC: J1.21, LCD2.10 (!D/C)
GND: C3.1, C4.1, C5.1, C6.1, C7.1, C9.1, J1.2, J1.13, J1.16, J1.27, LCD1.7 (VSS), LCD2.6 (VSS), R1.1, R6.1, S1.4, U$1.2, U$1.3
I2C-SCL: J1.18, LCD1.10 (SCL), R2.2
I2C-SDA: J1.19, LCD1.11 (SDA), R3.2
IREF: LCD1.12 (IREF), LCD2.13 (IREF), R1.2
unnamed: R5.2, T1.3 (D)
unnamed: R5.1, R6.2, U$1.1
unnamed: C7.2, LED1.C, R7.1, R8.2, S1.2
unnamed: C8.1, R9.1, T1.1 (G)
RST: LCD1.9 (!RES), LCD2.9 (!RES), SJ1.2
RST0: J1.17, SJ1.1
RST1: C3.2, R4.1, SJ1.3
SPI-CLK: J1.24, LCD2.11 (SCLK)
SPI-CS: J1.22, LCD2.8 (!CS)
SPI-MOSI: J1.25, LCD2.12 (SDIN)
SPKR: C8.2, J1.20
VBREF: LCD1.6 (VBREF)
VCC: C6.2, LCD1.14 (VCC), LCD2.15 (VCC)
VCOMH: C5.2, LCD1.13 (VCOMH), LCD2.14 (VCOMH)
VDD: C4.2, C9.2, J1.28, LCD1.5 (VBAT), LCD1.8 (VDD), LCD2.5 (VBAT), LCD2.7 (VDD), LED1.A, R2.1, R3.1, R4.2, R7.2, R9.2, T1.2 (S)

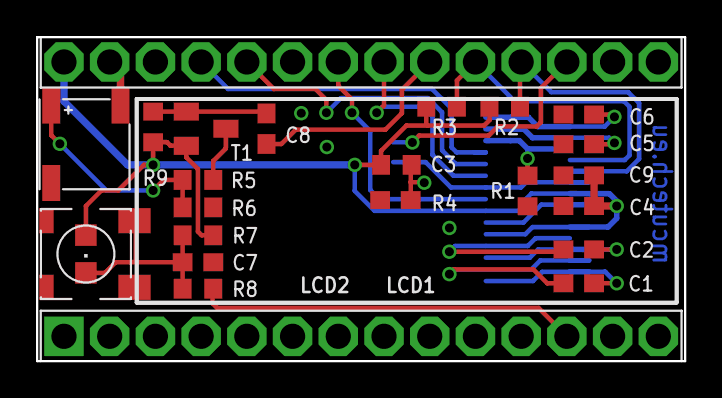
[picture p51: board EBN_OLED_V01.brd from above]

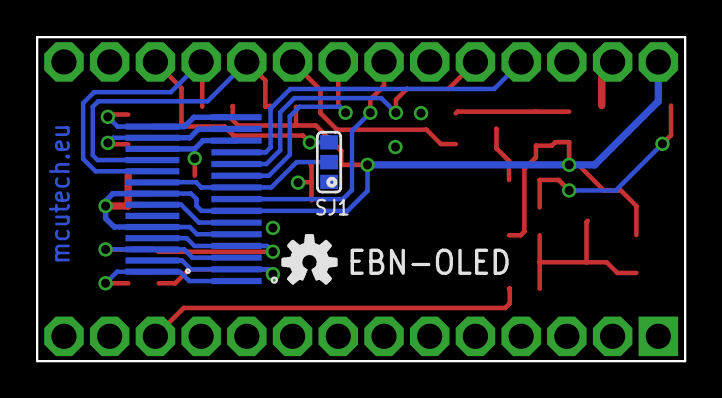
[picture p52: board EBN_OLED_V01.brd from below]

Board: 2 copper layers, 36.0 x 18.0 mm, 27 parts (2 on the bottom side), 24 nets.
