molejar/easyboard/hw/EBN_KL27Z4/eagle/EBN_KL27Z4_V05.brd

## EAGLE design hw/EBN_KL27Z4/eagle/EBN_KL27Z4_V05.brd (2019-03-24)

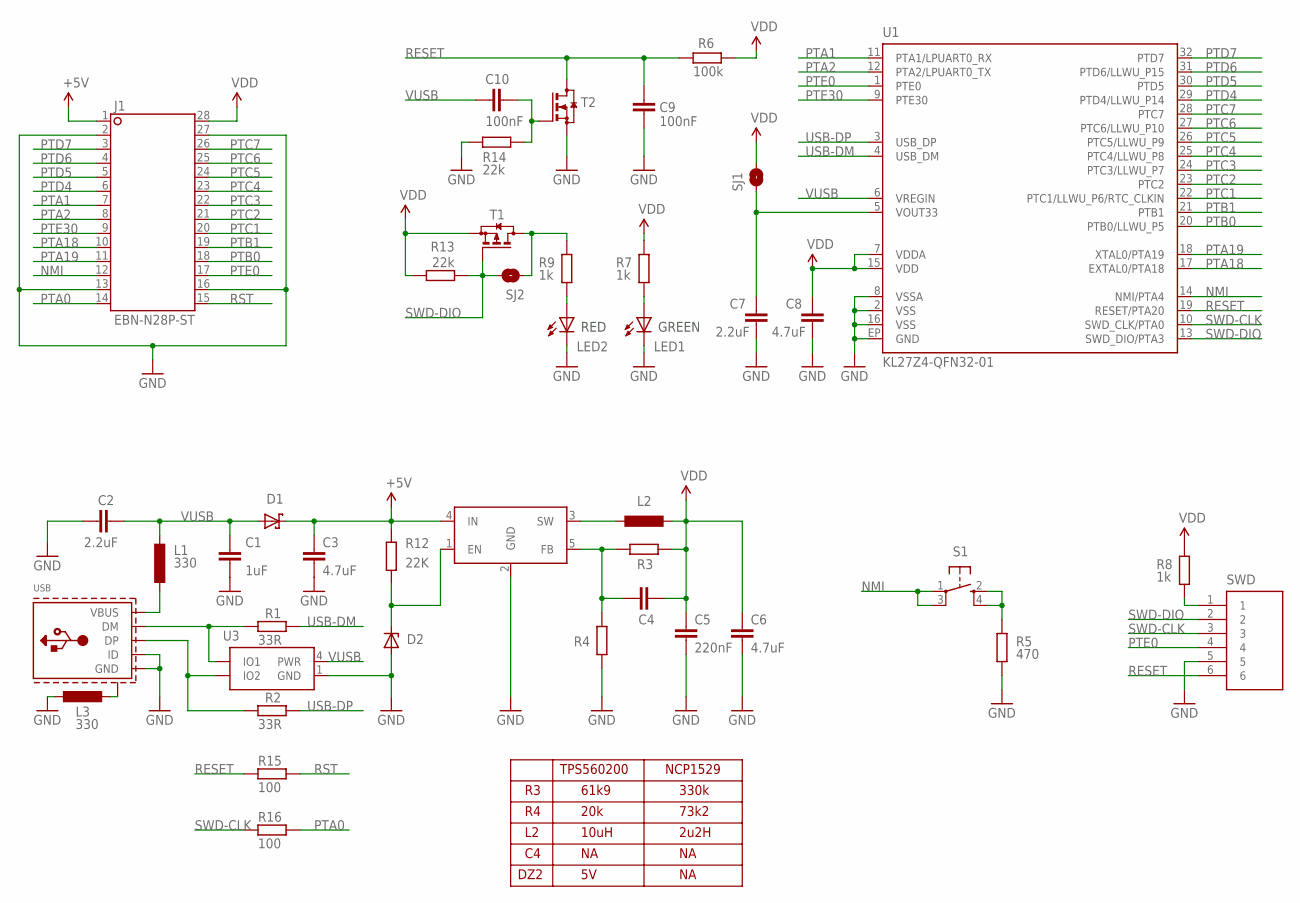
[picture p53: schematic EBN_KL27Z4_V05.sch]

Parts:
C1: 1uF; C0402
C2, C7: 2.2uF; C0603
C3, C6, C8: 4.7uF; C0603
C4: *; C0402
C5: 220nF; C0603
C9, C10: 100nF; C0402
D1: PMEG2010BER_SHOTTKY-SOD123FL; SOD-123FL
D2: DZ; SOD323_ST
J1: EBN-N28P-ST; EBN-N28P-SHIELD
L1, L3: 330; L0805
L2: 2u2; LPS3015
LED1, LED2: LEDCHIPLED_0603; CHIPLED_0603
R1, R2: 33R; R0402
R3, R4: *; R0402
R5: 470; R0402
R6: 100k; R0402
R7, R8, R9: 1k; R0402
R12: 22K; R0603
R13, R14: 22k; R0402
R15, R16: 100; R0402
S1: SWITCH-TACT2; KMR2
SJ1, SJ2: SJ-S; JUMPER-SMD-S1X
SWD: CON-1X6JST-SIDE; CON-JST1X6-SIDE
T1: -PMOS-SOT323; SOT323
T2: -NMOS-SOT323; SOT323
U1: KL27Z4-QFN32-01; QFN-32
U2: MP215P; SOT23-5L
U3: PRTR5V0U2X; SOT-143B
USB: USB-5P-MICRO-SMD-05; USB-MICRO-SMD-05

Connections:
+5V: C3.1, D1.C, J1.1, R12.2, U2.4 (IN)
DM: R1.1, U3.3 (IO1), USB.DM
DP: R2.1, U3.2 (IO2), USB.DP
GND: C1.1, C2.2, C3.2, C5.2, C6.2, C7.2, C8.2, C9.2, D2.A, J1.2, J1.13, J1.16, J1.27, L3.2, LED1.C, LED2.C, R4.1, R5.1, R14.1, SWD.5, T2.2 (S), U1.2 (VSS), U1.8 (VSSA), U1.16 (VSS), U1.EP (GND), U2.2 (GND), U3.1 (GND), USB.GND, USB.ID
unnamed: L1.1, USB.VBUS
unnamed: L3.1, USB.SHILD@1 (SHILD), USB.SHILD@2 (SHILD), USB.SHILD@3 (SHILD), USB.SHILD@4 (SHILD)
unnamed: LED1.A, R7.1
unnamed: D2.C, R12.1, U2.1 (EN)
unnamed: R5.2, S1.2 (3), S1.4
unnamed: C7.1, SJ1.1, U1.5 (VOUT33)
unnamed: R8.1, SWD.1
unnamed: LED2.A, R9.1
unnamed: R9.2, SJ2.1, T1.3 (D)
unnamed: C10.2, R14.2, T2.1 (G)
unnamed: L2.P$1 (1), U2.3 (SW)
unnamed: C4.1, R3.1, R4.2, U2.5 (FB)
NMI: J1.12, S1.1, S1.3 (2), U1.14 (NMI/PTA4)
PTA0: J1.14, R16.1
PTA1: J1.7, U1.11 (PTA1/LPUART0_RX)
PTA2: J1.8, U1.12 (PTA2/LPUART0_TX)
PTA18: J1.10, U1.17 (EXTAL0/PTA18)
PTA19: J1.11, U1.18 (XTAL0/PTA19)
PTB0: J1.18, U1.20 (PTB0/LLWU_P5)
PTB1: J1.19, U1.21 (PTB1)
PTC1: J1.20, U1.22 (PTC1/LLWU_P6/RTC_CLKIN)
PTC2: J1.21, U1.23 (PTC2)
PTC3: J1.22, U1.24 (PTC3/LLWU_P7)
PTC4: J1.23, U1.25 (PTC4/LLWU_P8)
PTC5: J1.24, U1.26 (PTC5/LLWU_P9)
PTC6: J1.25, U1.27 (PTC6/LLWU_P10)
PTC7: J1.26, U1.28 (PTC7)
PTD4: J1.6, U1.29 (PTD4/LLWU_P14)
PTD5: J1.5, U1.30 (PTD5)
PTD6: J1.4, U1.31 (PTD6/LLWU_P15)
PTD7: J1.3, U1.32 (PTD7)
PTE0: J1.17, SWD.4, U1.1 (PTE0)
PTE30: J1.9, U1.9 (PTE30)
RESET: C9.1, R6.2, R15.2, SWD.6, T2.3 (D), U1.19 (RESET/PTA20)
RST: J1.15, R15.1
SWD-CLK: R16.2, SWD.3, U1.10 (SWD_CLK/PTA0)
SWD-DIO: R13.1, SJ2.2, SWD.2, T1.1 (G), U1.13 (SWD_DIO/PTA3)
USB-DM: R1.2, U1.4 (USB_DM)
USB-DP: R2.2, U1.3 (USB_DP)
VDD: C4.2, C5.1, C6.1, C8.1, J1.28, L2.P$2 (2), R3.2, R6.1, R7.2, R8.2, R13.2, SJ1.2, T1.2 (S), U1.7 (VDDA), U1.15 (VDD)
VUSB: C1.2, C2.1, C10.1, D1.A, L1.2, U1.6 (VREGIN), U3.4 (PWR)

Notes on the sheet:
TPS560200
NCP1529
61k9
20k
10uH
330k
73k2
2u2H
DZ2
RED
GREEN

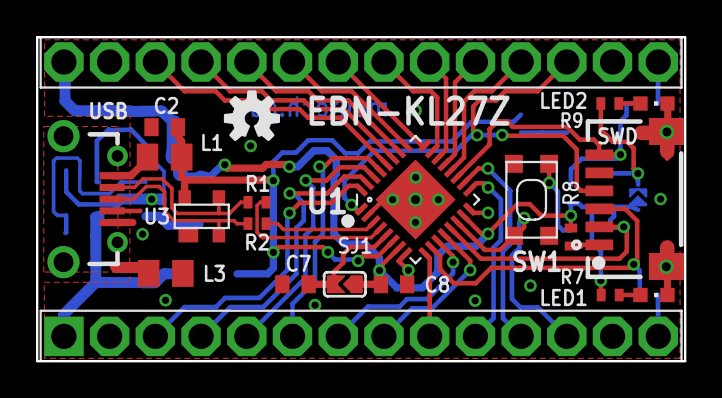
[picture p54: board EBN_KL27Z4_V05.brd from above]

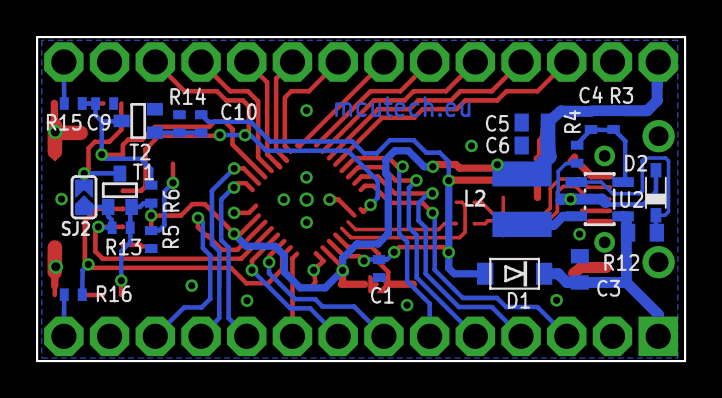
[picture p55: board EBN_KL27Z4_V05.brd from below]

Board: 2 copper layers, 36.0 x 18.0 mm, 43 parts (23 on the bottom side), 45 nets.

Other parts of the board:
U$2: OSHW-LOGO-S
