molejar/easyboard/hw/EBN_S12D/eagle/EBN_Sensors_V02.brd

## EAGLE design hw/EBN_S12D/eagle/EBN_Sensors_V02.brd (2019-03-24)

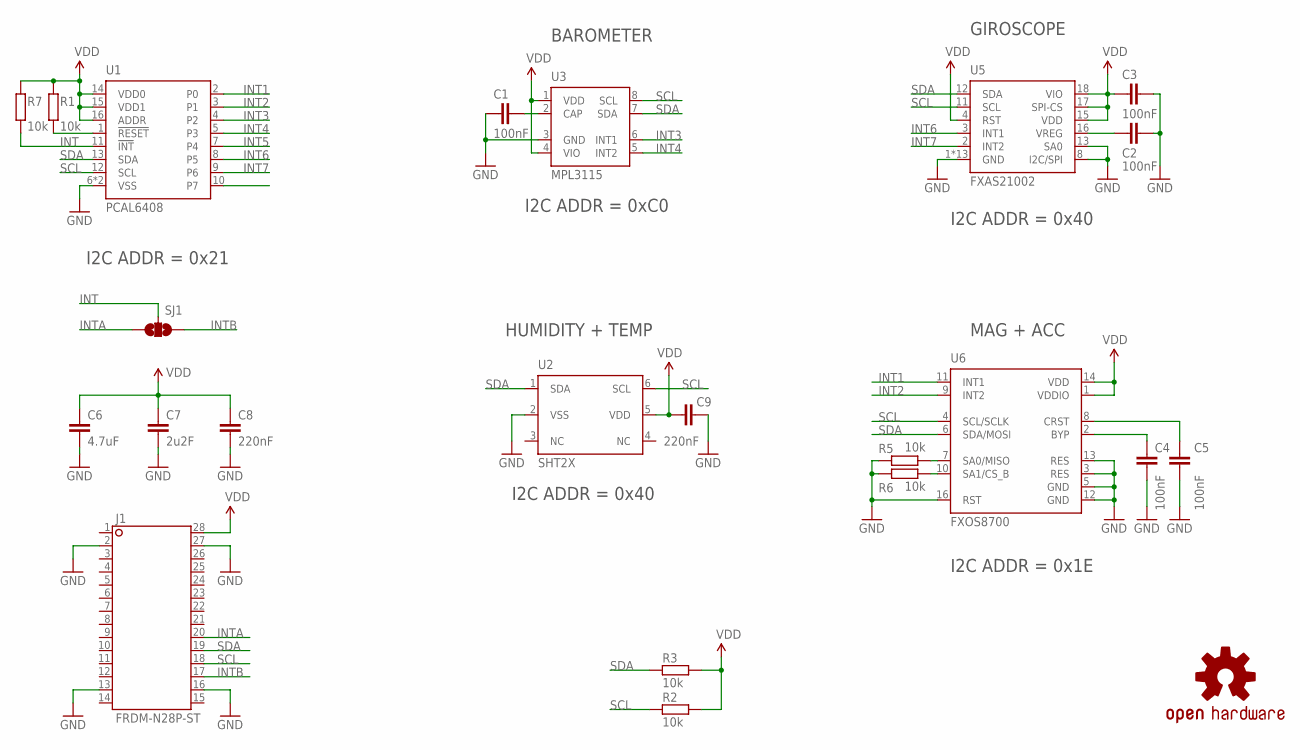
[picture p56: schematic EBN_Sensors_V02.sch]

Parts:
C1, C2, C3, C4, C5: 100nF; C0402
C6: 4.7uF; C0603
C7: 2u2F; C0603
C8, C9: 220nF; C0402
J1: FRDM-N28P-ST; FRDM-N28P-SHIELD
LOGO1: OSHW-LOGOS; OSHW-LOGO-S
R1, R2, R3, R5, R6, R7: 10k; R0402
SJ1: SJ2W-S; JUMPER-SMD-S2X
U1: PCAL6408; QFN16-3X3MM
U2: SHT2X; DFN6_3X3
U3: MPL3115; LGA-8
U5: FXAS21002; QFN24
U6: FXOS8700; QFN16-FX

Connections:
GND: C1.1, C2.1, C3.1, C4.2, C5.2, C6.2, C7.2, C8.2, C9.1, J1.2, J1.13, J1.16, J1.27, R5.2, R6.2, U1.6 (VSS), U1.EXT (VSS), U2.2 (VSS), U3.3 (GND), U5.1 (GND), U5.5 (GND), U5.6 (GND), U5.7 (GND), U5.8 (I2C/SPI), U5.9 (GND), U5.10 (GND), U5.13 (SA0), U5.14 (GND), U5.19 (GND), U5.20 (GND), U5.21 (GND), U5.22 (GND), U5.23 (GND), U5.24 (GND), U6.3 (RES), U6.5 (GND), U6.12 (GND), U6.13 (RES), U6.16 (RST)
INT: R7.2, SJ1.2, U1.11 (!INT)
INT1: U1.2 (P0), U6.11 (INT1)
INT2: U1.3 (P1), U6.9 (INT2)
INT3: U1.4 (P2), U3.6 (INT1)
INT4: U1.5 (P3), U3.5 (INT2)
INT5: U1.7 (P4)
INT6: U1.8 (P5), U5.3 (INT1)
INT7: U1.9 (P6), U5.2 (INT2)
INTA: J1.20, SJ1.3
INTB: J1.17, SJ1.1
unnamed: R5.1, U6.7 (SA0/MISO)
unnamed: R6.1, U6.10 (SA1/CS_B)
unnamed: C2.2, U5.16 (VREG)
unnamed: R1.2, U1.1 (!RESET)
unnamed: C1.2, U3.2 (CAP)
unnamed: C4.1, U6.2 (BYP)
unnamed: C5.1, U6.8 (CRST)
SCL: J1.18, R2.1, U1.12 (SCL), U2.6 (SCL), U3.8 (SCL), U5.11 (SCL), U6.4 (SCL/SCLK)
SDA: J1.19, R3.1, U1.13 (SDA), U2.1 (SDA), U3.7 (SDA), U5.12 (SDA), U6.6 (SDA/MOSI)
VDD: C3.2, C6.1, C7.1, C8.1, C9.2, J1.28, R1.1, R2.2, R3.2, R7.1, U1.14 (VDD0), U1.15 (VDD1), U1.16 (ADDR), U2.5 (VDD), U3.1 (VDD), U3.4 (VIO), U5.4 (RST), U5.15 (VDD), U5.17 (SPI-CS), U5.18 (VIO), U6.1 (VDDIO), U6.14 (VDD)

Notes on the sheet:
I2C ADDR = 0x21
I2C ADDR = 0x1E
I2C ADDR = 0x40
I2C ADDR = 0xC0
MAG + ACC
GIROSCOPE
BAROMETER
HUMIDITY + TEMP

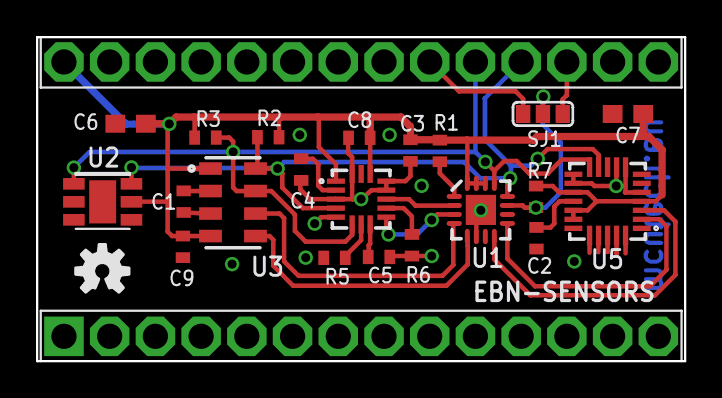
[picture p57: board EBN_Sensors_V02.brd from above]

Board: 2 copper layers, 36.0 x 18.0 mm, 23 parts (0 on the bottom side), 20 nets.
