molejar/easyboard/hw/EBN_GPS/eagle/EBN_GPS_V02.brd

## EAGLE design hw/EBN_GPS/eagle/EBN_GPS_V02.brd (2019-03-24)

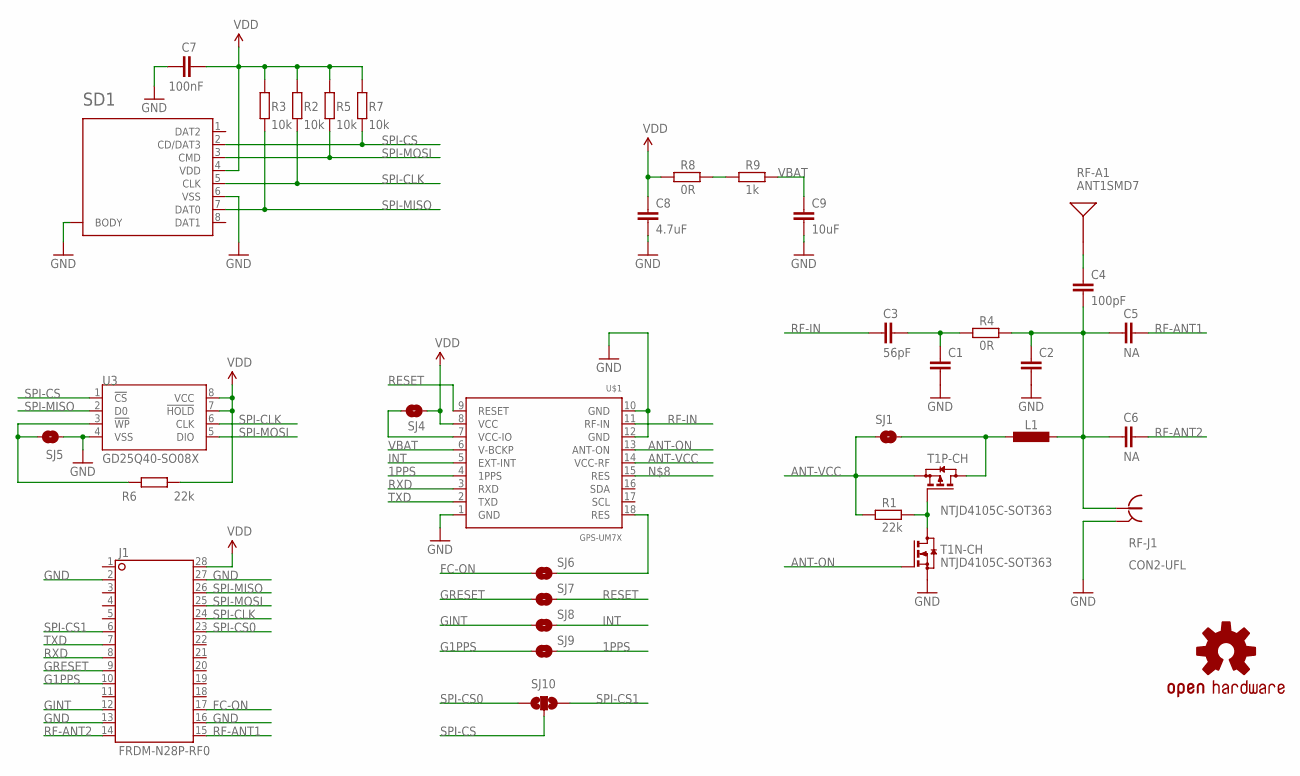
[picture p58: schematic EBN_GPS_V02.sch]

Parts:
C1, C2: C-EUC0402; C0402
C3: 56pF; C0402
C4: 100pF; C0402
C5, C6: NA; C0603
C7: 100nF; C0402
C8: 4.7uF; C0805
C9: 10uF; C0805
J1: FRDM-N28P-RF0; EBN-N28P-SHRF0
L1: L-EUL0603; L0603
LOGO1: OSHW-LOGOM; OSHW-LOGO-M
R1, R6: 22k; R0402
R2, R3, R5, R7: 10k; R0402
R4: 0R; R0402
R8: 0R; R0603
R9: 1k; R0603
RF-A1: ANT1SMD7; ANT-GPS0
RF-J1: CON2-UFL; RF-CON-U.FL
SD1: SDCARD00; MICRO-SD-00
SJ1, SJ4, SJ5, SJ6, SJ7, SJ8, SJ9: SJ-S; JUMPER-SMD-S1X
SJ10: SJ2W-S; JUMPER-SMD-S2X
T1: NTJD4105C-SOT363; SOT363
U3: GD25Q40-SO08X; SO08X
U$1: GPS-UM7X; GPS-XX7X

Connections:
1PPS: SJ9.2, U$1.4 (1PPS)
ANT-ON: T1.2 (G), U$1.13 (ANT-ON)
ANT-VCC: R1.2, SJ1.1, T1.4 (S), U$1.14 (VCC-RF)
FC-ON: J1.17, SJ6.1
G1PPS: J1.10, SJ9.1
GINT: J1.12, SJ8.1
GND: C1.2, C2.2, C7.2, C8.2, C9.2, J1.2, J1.13, J1.16, J1.27, RF-J1.GND@0 (GND), RF-J1.GND@1 (GND), RF-J1.GND@2 (GND), SD1.6 (VSS), SD1.SHELD@0 (BODY), SD1.SHELD@1 (BODY), SJ5.1, T1.1 (S), U3.4 (VSS), U$1.1 (GND), U$1.10 (GND), U$1.12 (GND)
GRESET: J1.9, SJ7.1
INT: SJ8.2, U$1.5 (EXT-INT)
unnamed: C4.1, RF-A1.SIG
unnamed: R8.1, R9.2
unnamed: SJ6.2, U$1.18 (RES)
unnamed: R6.2, SJ5.2, U3.3 (!WP)
unnamed: SJ4.1, U$1.7 (VCC-IO)
unnamed: R1.1, T1.5 (G), T1.6 (D)
unnamed: L1.1, SJ1.2, T1.3 (D)
unnamed: C2.1, C4.2, C5.1, C6.1, L1.2, R4.1, RF-J1.SIG
unnamed: C1.1, C3.2, R4.2
RESET: SJ7.2, U$1.9 (RESET)
RF-ANT1: C5.2, J1.15
RF-ANT2: C6.2, J1.14
RF-IN: C3.1, U$1.11 (RF-IN)
RXD: J1.8, U$1.3 (RXD)
SPI-CLK: J1.24, R2.1, SD1.5 (CLK), U3.6 (CLK)
SPI-CS: R7.1, SD1.2 (CD/DAT3), SJ10.2, U3.1 (!CS)
SPI-CS0: J1.23, SJ10.1
SPI-CS1: J1.6, SJ10.3
SPI-MISO: J1.26, R3.1, SD1.7 (DAT0), U3.2 (D0)
SPI-MOSI: J1.25, R5.1, SD1.3 (CMD), U3.5 (DIO)
TXD: J1.7, U$1.2 (TXD)
VBAT: C9.1, R9.1, U$1.6 (V-BCKP)
VDD: C7.1, C8.1, J1.28, R2.2, R3.2, R5.2, R6.1, R7.2, R8.2, SD1.4 (VDD), SJ4.2, U3.7 (!HOLD), U3.8 (VCC), U$1.8 (VCC)
