molejar/easyboard/hw/EBN_GPS/eagle/EBN_GPS_V02.brd

## EAGLE design hw/EBN_GPS/eagle/EBN_GPS_V02.brd (continued)

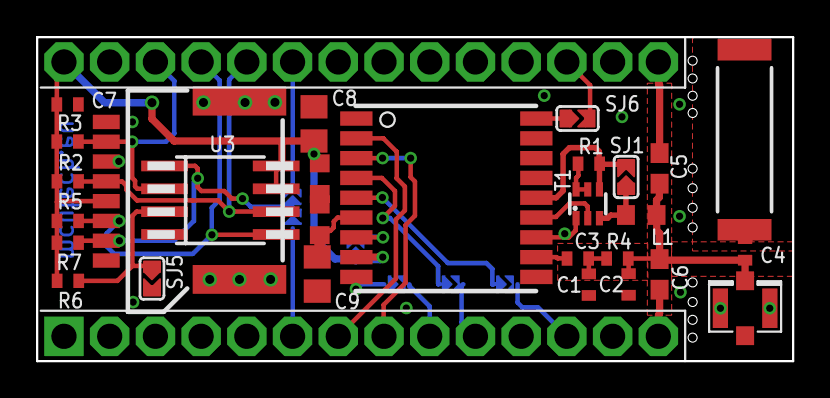
[picture p59: board EBN_GPS_V02.brd from above]

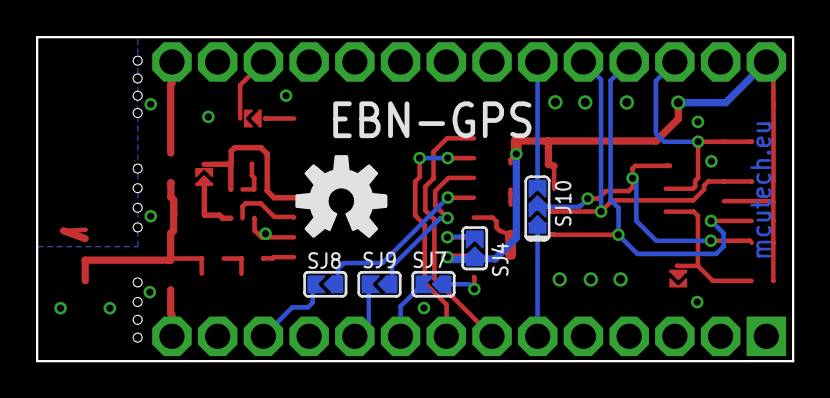
[picture p60: board EBN_GPS_V02.brd from below]

Board: 2 copper layers, 42.0 x 18.0 mm, 35 parts (6 on the bottom side), 32 nets.
