molejar/easyboard/hw/EBN_DUAL/eagle/EBN_DUAL_V01.brd

## EAGLE design hw/EBN_DUAL/eagle/EBN_DUAL_V01.brd (2019-03-24)

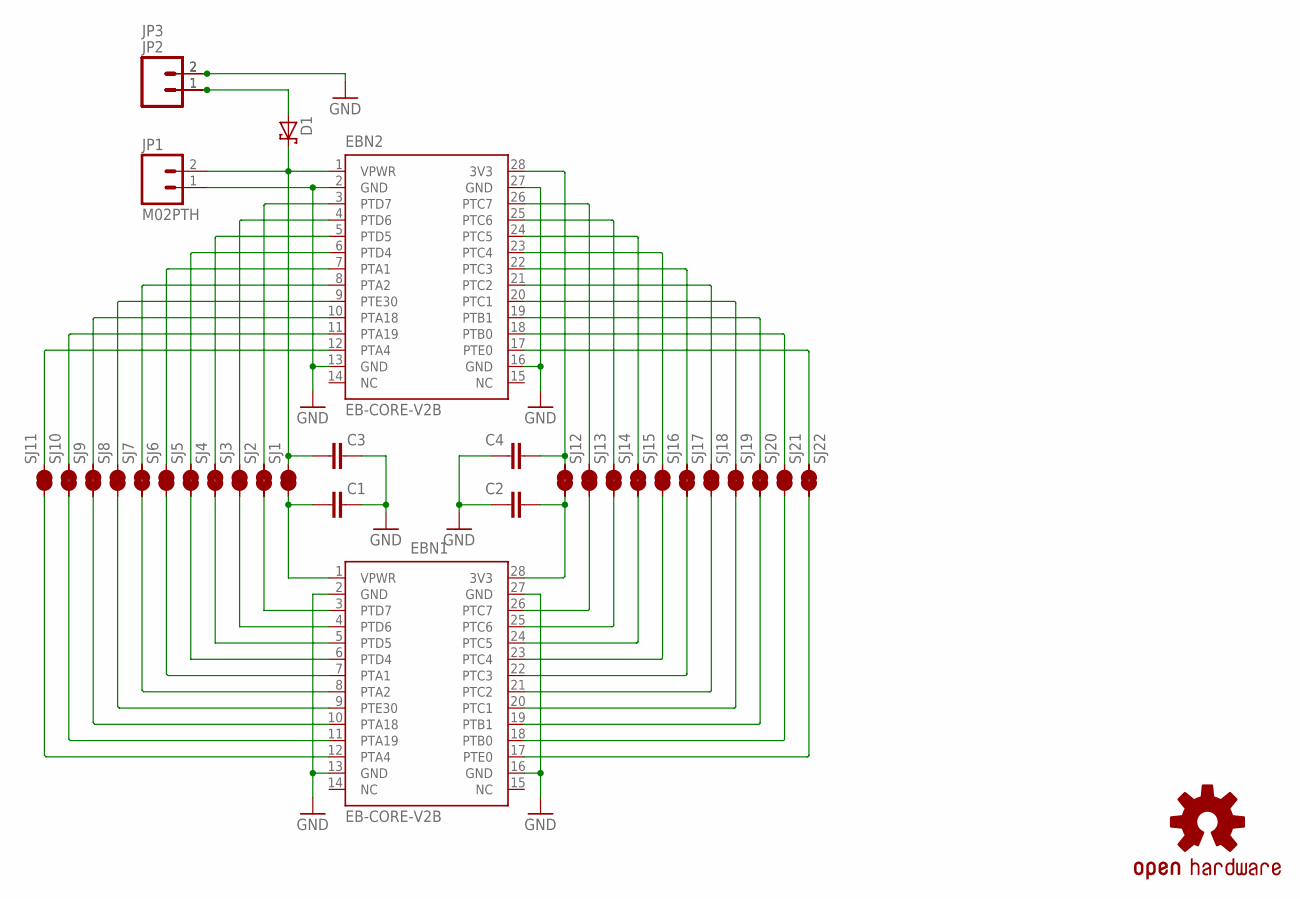
[picture p61: schematic EBN_DUAL_V01.sch]

Parts:
C1, C2, C3, C4: C-EUC0603; C0603
D1: PMEG2010BER-SHOTTKY-SOD123FL; SOD-123FL
EBN1, EBN2: EB-CORE-V2B; DIL28-6B
JP1: M02PTH; 1X02
JP2: M02SMD; 1X02-1.25MM_SMD
JP3: M02PTH3; 1X02_LONGPADS
LOGO1: OSHW-LOGOS; OSHW-LOGO-S
SJ1, SJ2, SJ3, SJ4, SJ5, SJ6, SJ7, SJ8, SJ9, SJ10, SJ11, SJ12, SJ13, SJ14, SJ15, SJ16, SJ17, SJ18, SJ19, SJ20, SJ21, SJ22: SJS; JUMPER-SMD-S1XS

Connections:
GND: C1.2, C2.1, C3.2, C4.1, EBN1.2 (GND), EBN1.13 (GND), EBN1.16 (GND), EBN1.27 (GND), EBN2.2 (GND), EBN2.13 (GND), EBN2.16 (GND), EBN2.27 (GND), JP1.1, JP2.2, JP3.2
unnamed: C4.2, EBN2.28 (3V3), SJ12.2
unnamed: EBN1.26 (PTC7), SJ13.1
unnamed: EBN2.26 (PTC7), SJ13.2
unnamed: EBN2.25 (PTC6), SJ14.2
unnamed: EBN2.24 (PTC5), SJ15.2
unnamed: EBN2.23 (PTC4), SJ16.2
unnamed: EBN2.22 (PTC3), SJ17.2
unnamed: EBN2.21 (PTC2), SJ18.2
unnamed: EBN2.20 (PTC1), SJ19.2
unnamed: EBN2.19 (PTB1), SJ20.2
unnamed: EBN2.18 (PTB0), SJ21.2
unnamed: EBN2.17 (PTE0), SJ22.2
unnamed: EBN2.7 (PTA1), SJ6.2
unnamed: C3.1, D1.C, EBN2.1 (VPWR), JP1.2, SJ1.2
unnamed: D1.A, JP2.1, JP3.1
unnamed: EBN2.3 (PTD7), SJ2.2
unnamed: EBN2.4 (PTD6), SJ3.2
unnamed: EBN2.5 (PTD5), SJ4.2
unnamed: EBN2.6 (PTD4), SJ5.2
unnamed: EBN2.8 (PTA2), SJ7.2
unnamed: EBN2.9 (PTE30), SJ8.2
unnamed: EBN2.10 (PTA18), SJ9.2
unnamed: EBN2.11 (PTA19), SJ10.2
unnamed: EBN2.12 (PTA4), SJ11.2
unnamed: C1.1, EBN1.1 (VPWR), SJ1.1
unnamed: EBN1.3 (PTD7), SJ2.1
unnamed: EBN1.4 (PTD6), SJ3.1
unnamed: EBN1.5 (PTD5), SJ4.1
unnamed: EBN1.6 (PTD4), SJ5.1
unnamed: EBN1.7 (PTA1), SJ6.1
unnamed: EBN1.8 (PTA2), SJ7.1
unnamed: EBN1.9 (PTE30), SJ8.1
unnamed: EBN1.10 (PTA18), SJ9.1
unnamed: EBN1.11 (PTA19), SJ10.1
unnamed: EBN1.12 (PTA4), SJ11.1
unnamed: C2.2, EBN1.28 (3V3), SJ12.1
unnamed: EBN1.25 (PTC6), SJ14.1
unnamed: EBN1.24 (PTC5), SJ15.1
unnamed: EBN1.23 (PTC4), SJ16.1
unnamed: EBN1.22 (PTC3), SJ17.1
unnamed: EBN1.21 (PTC2), SJ18.1
unnamed: EBN1.20 (PTC1), SJ19.1
unnamed: EBN1.19 (PTB1), SJ20.1
unnamed: EBN1.18 (PTB0), SJ21.1
unnamed: EBN1.17 (PTE0), SJ22.1

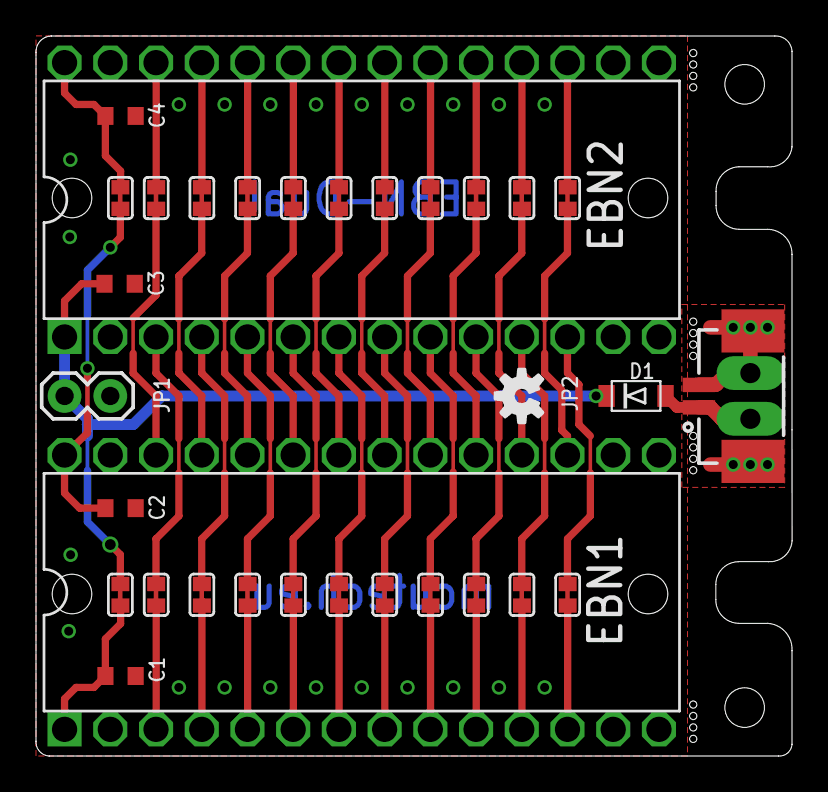
[picture p62: board EBN_DUAL_V01.brd from above]

Board: 2 copper layers, 42.0 x 40.0 mm, 33 parts (0 on the bottom side), 46 nets.
